navipack/navi-panel/Hardware/Smart Chassis control board schematic.pdf

D | D

# 激 光 雷 达

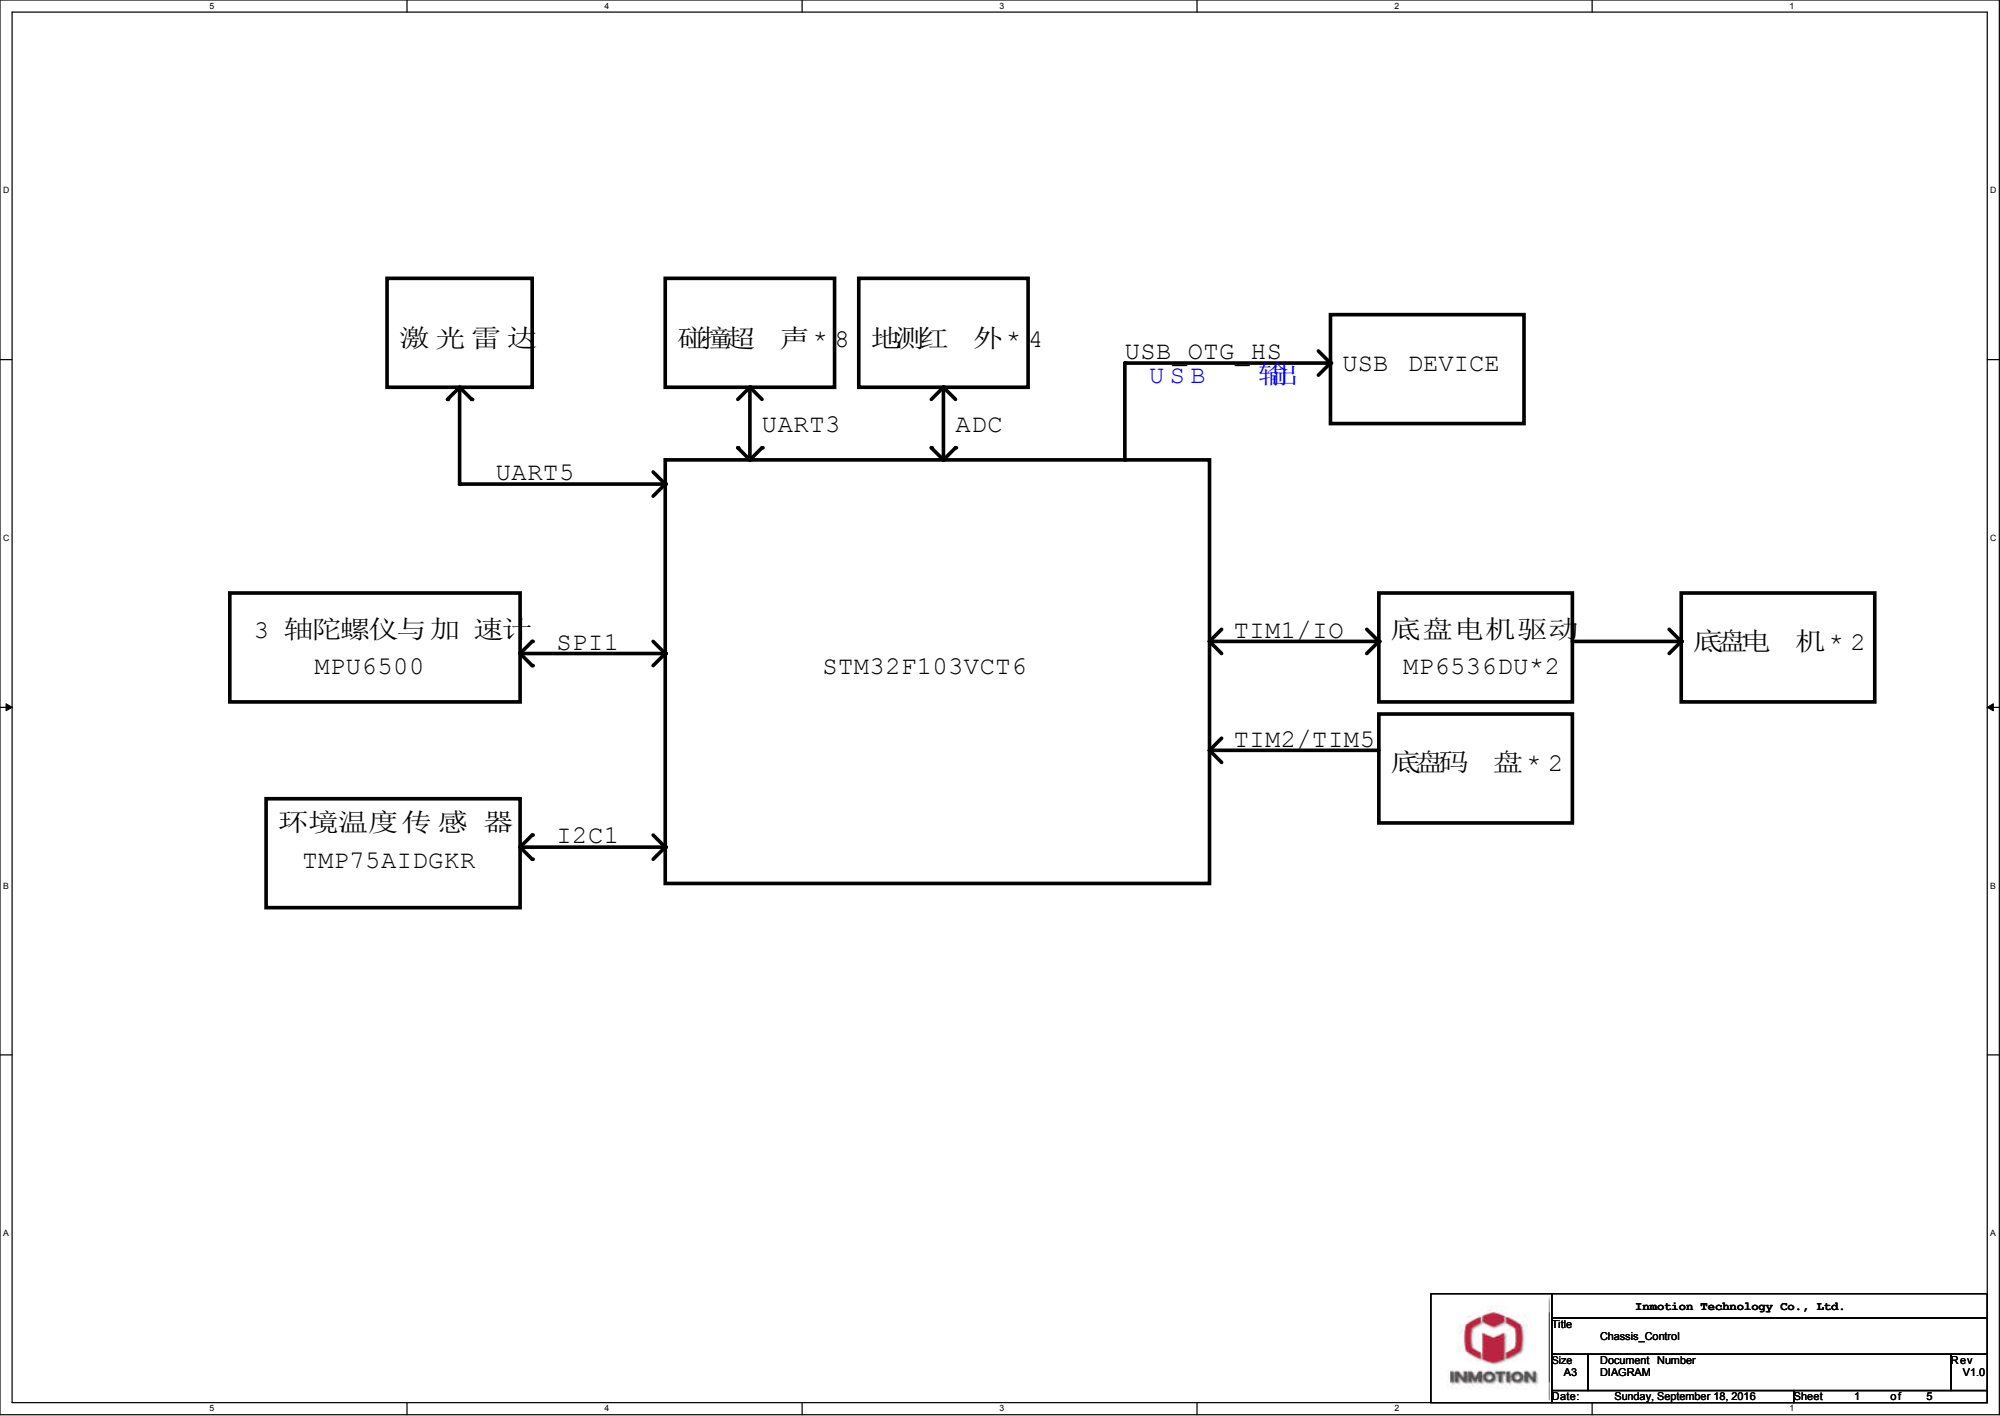
[picture p6: page 1]
STM32F103VCT6; UART5; MPU6500; SPI1 3 轴陀螺仪与加 速计; 碰撞超 声* 8; UART3; 地测红 外* 4; ADC; TMP75AIDGKR; 环境温度传 感 器; TIM1/IO; 底盘电机驱动; 底盘电 机* 2; 底盘码 盘* 2; TIM2/TIM5; USB_OTG_HS; USB DEVICE U S B; Title; Size; Document Number; Rev; Date:; Sheet; DIAGRAM; Chassis_Control; Sunday, September 18, 2016

Inmotion Technology Co., Ltd.

D | D

# CHARGE

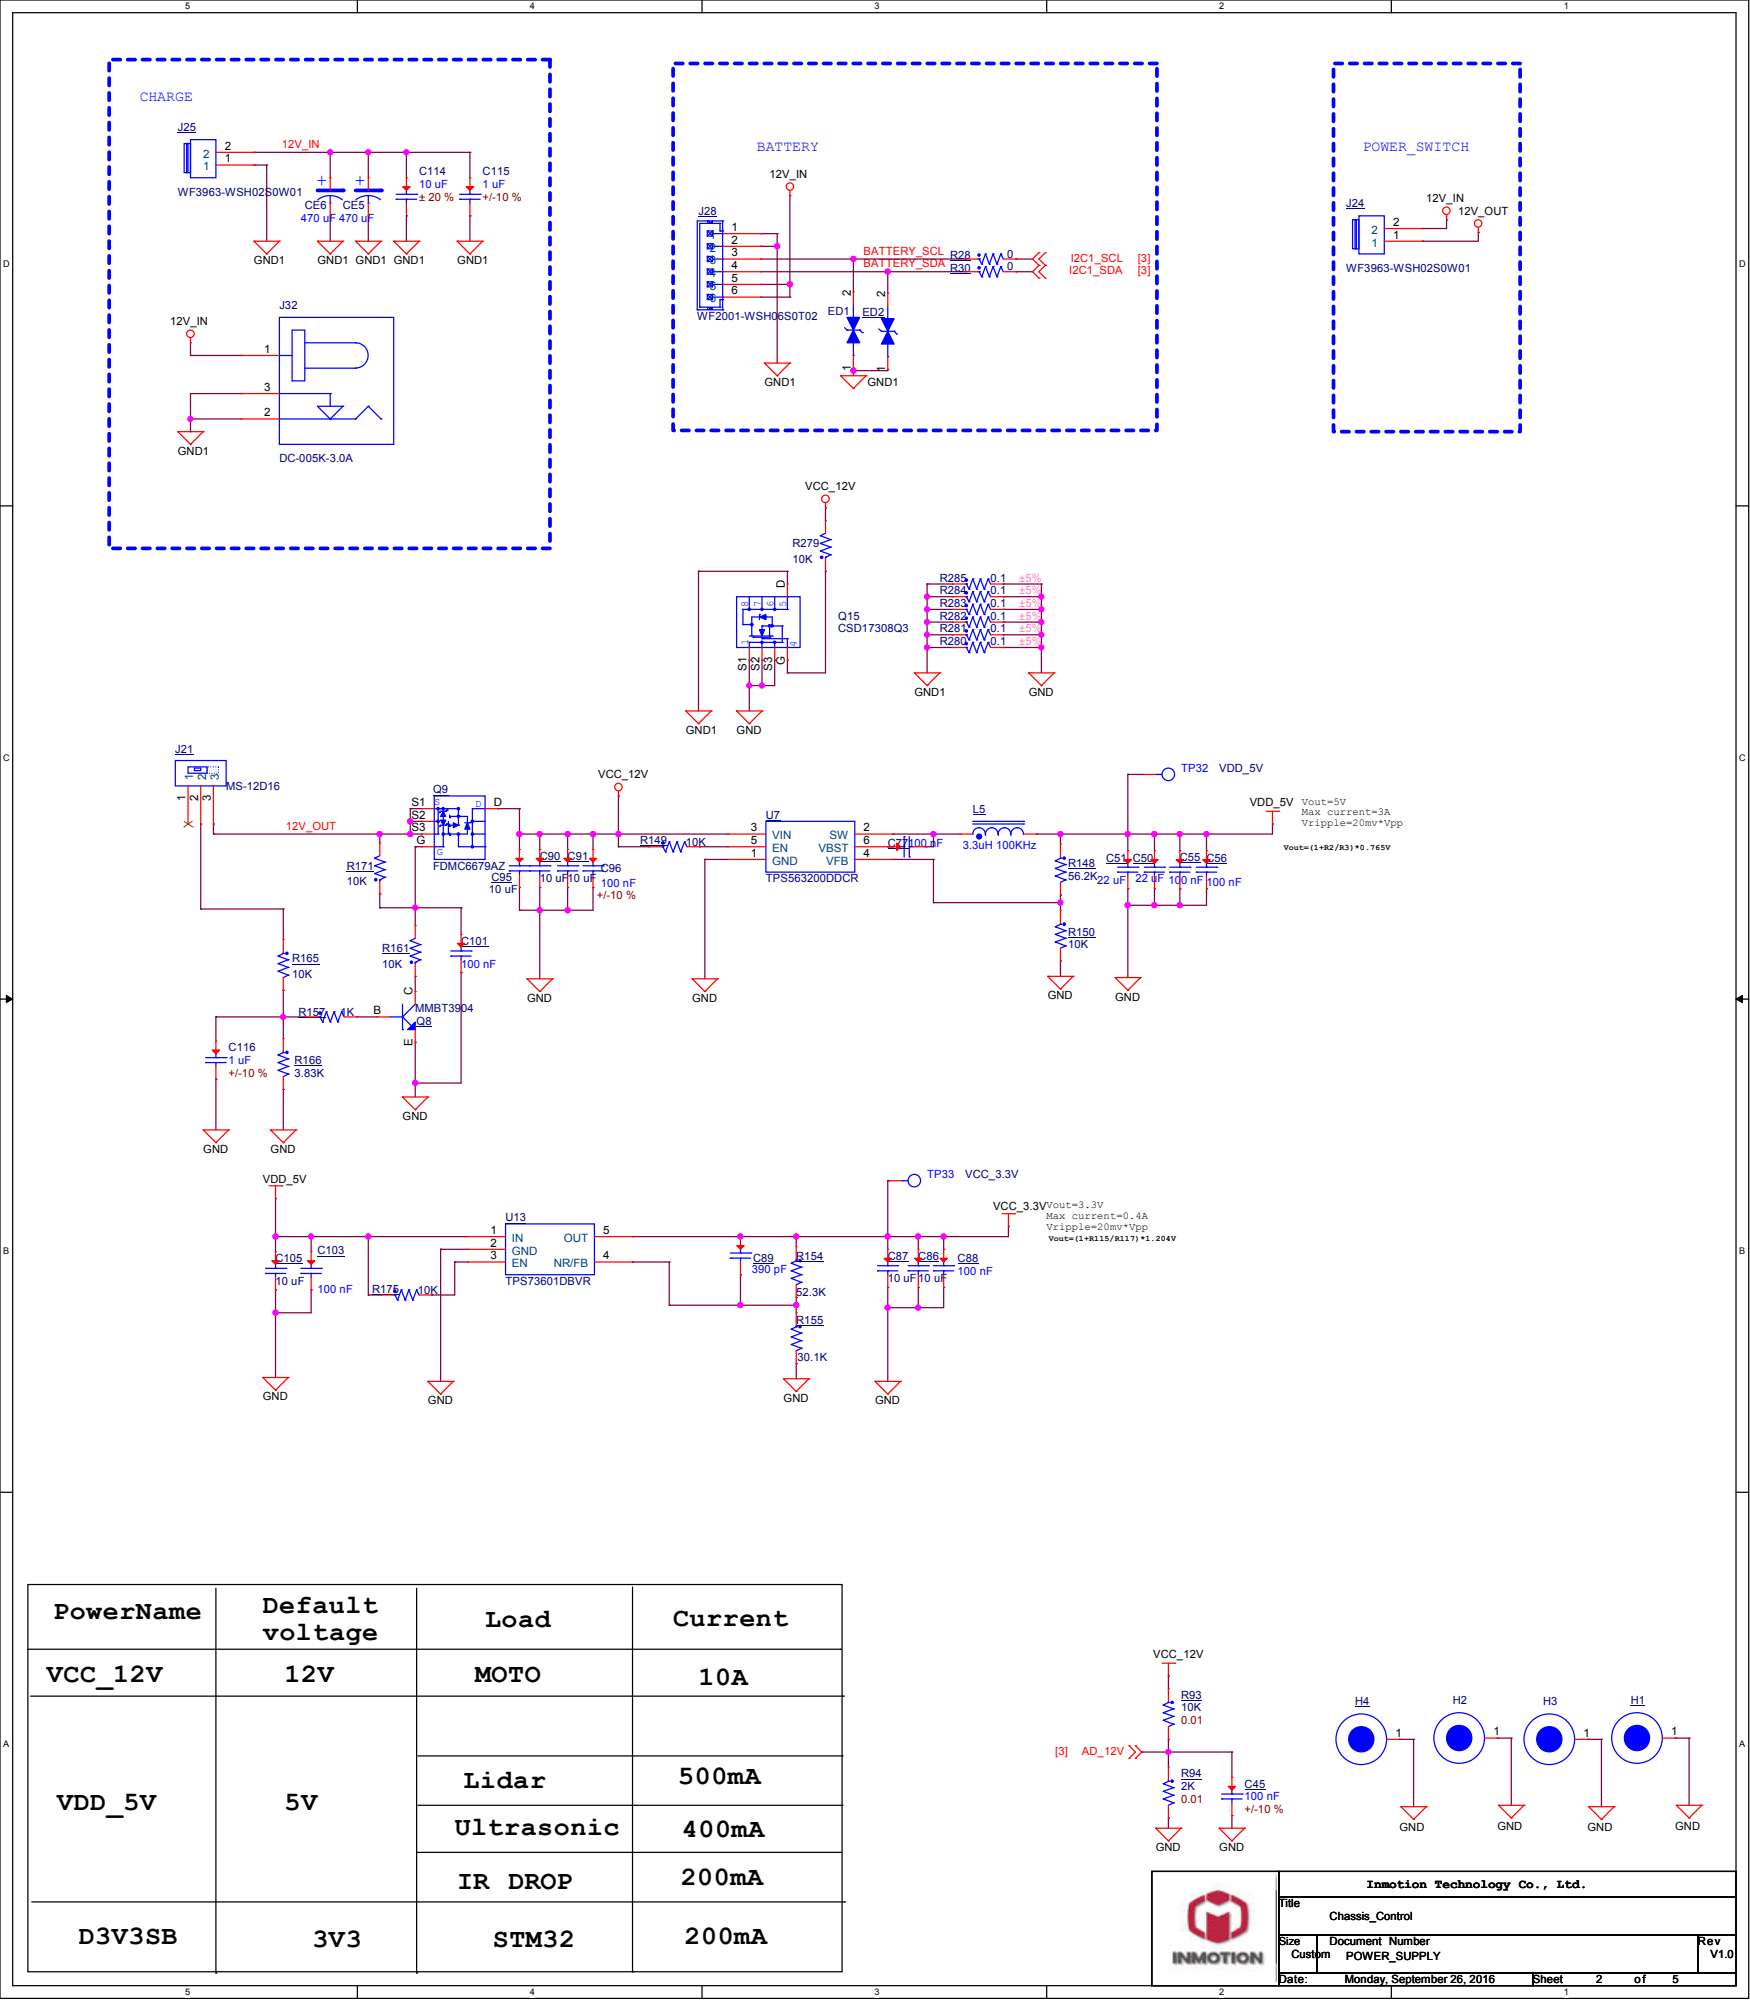
[picture p7: page 2]

# DEBUG

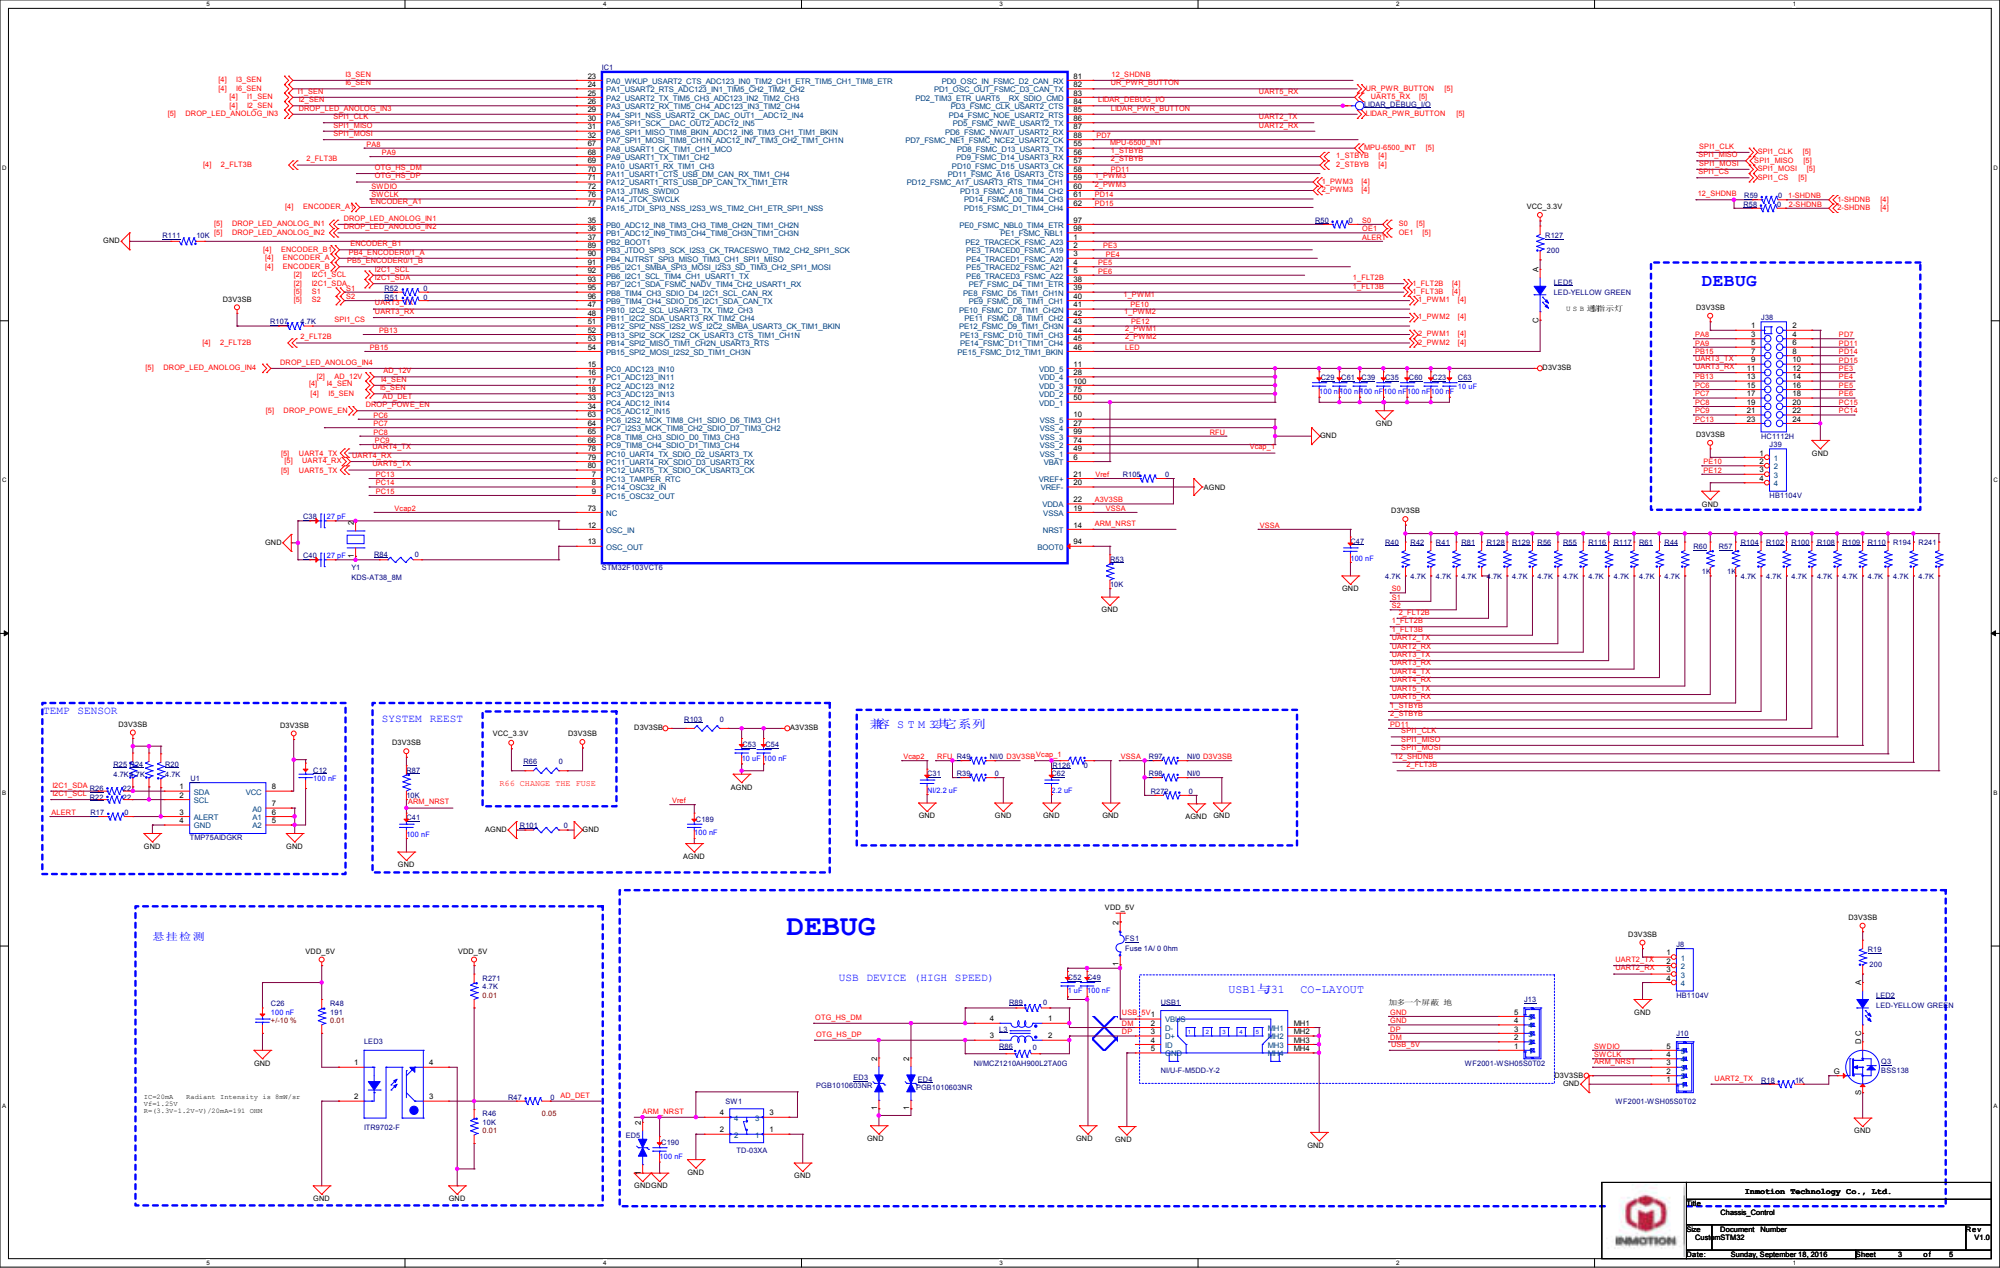
[picture p8: page 3]

USB DEVICE (HIGH SPEED)

MOTOR DRIVER | CURRENT SAMPLING 1-FAULTB

+

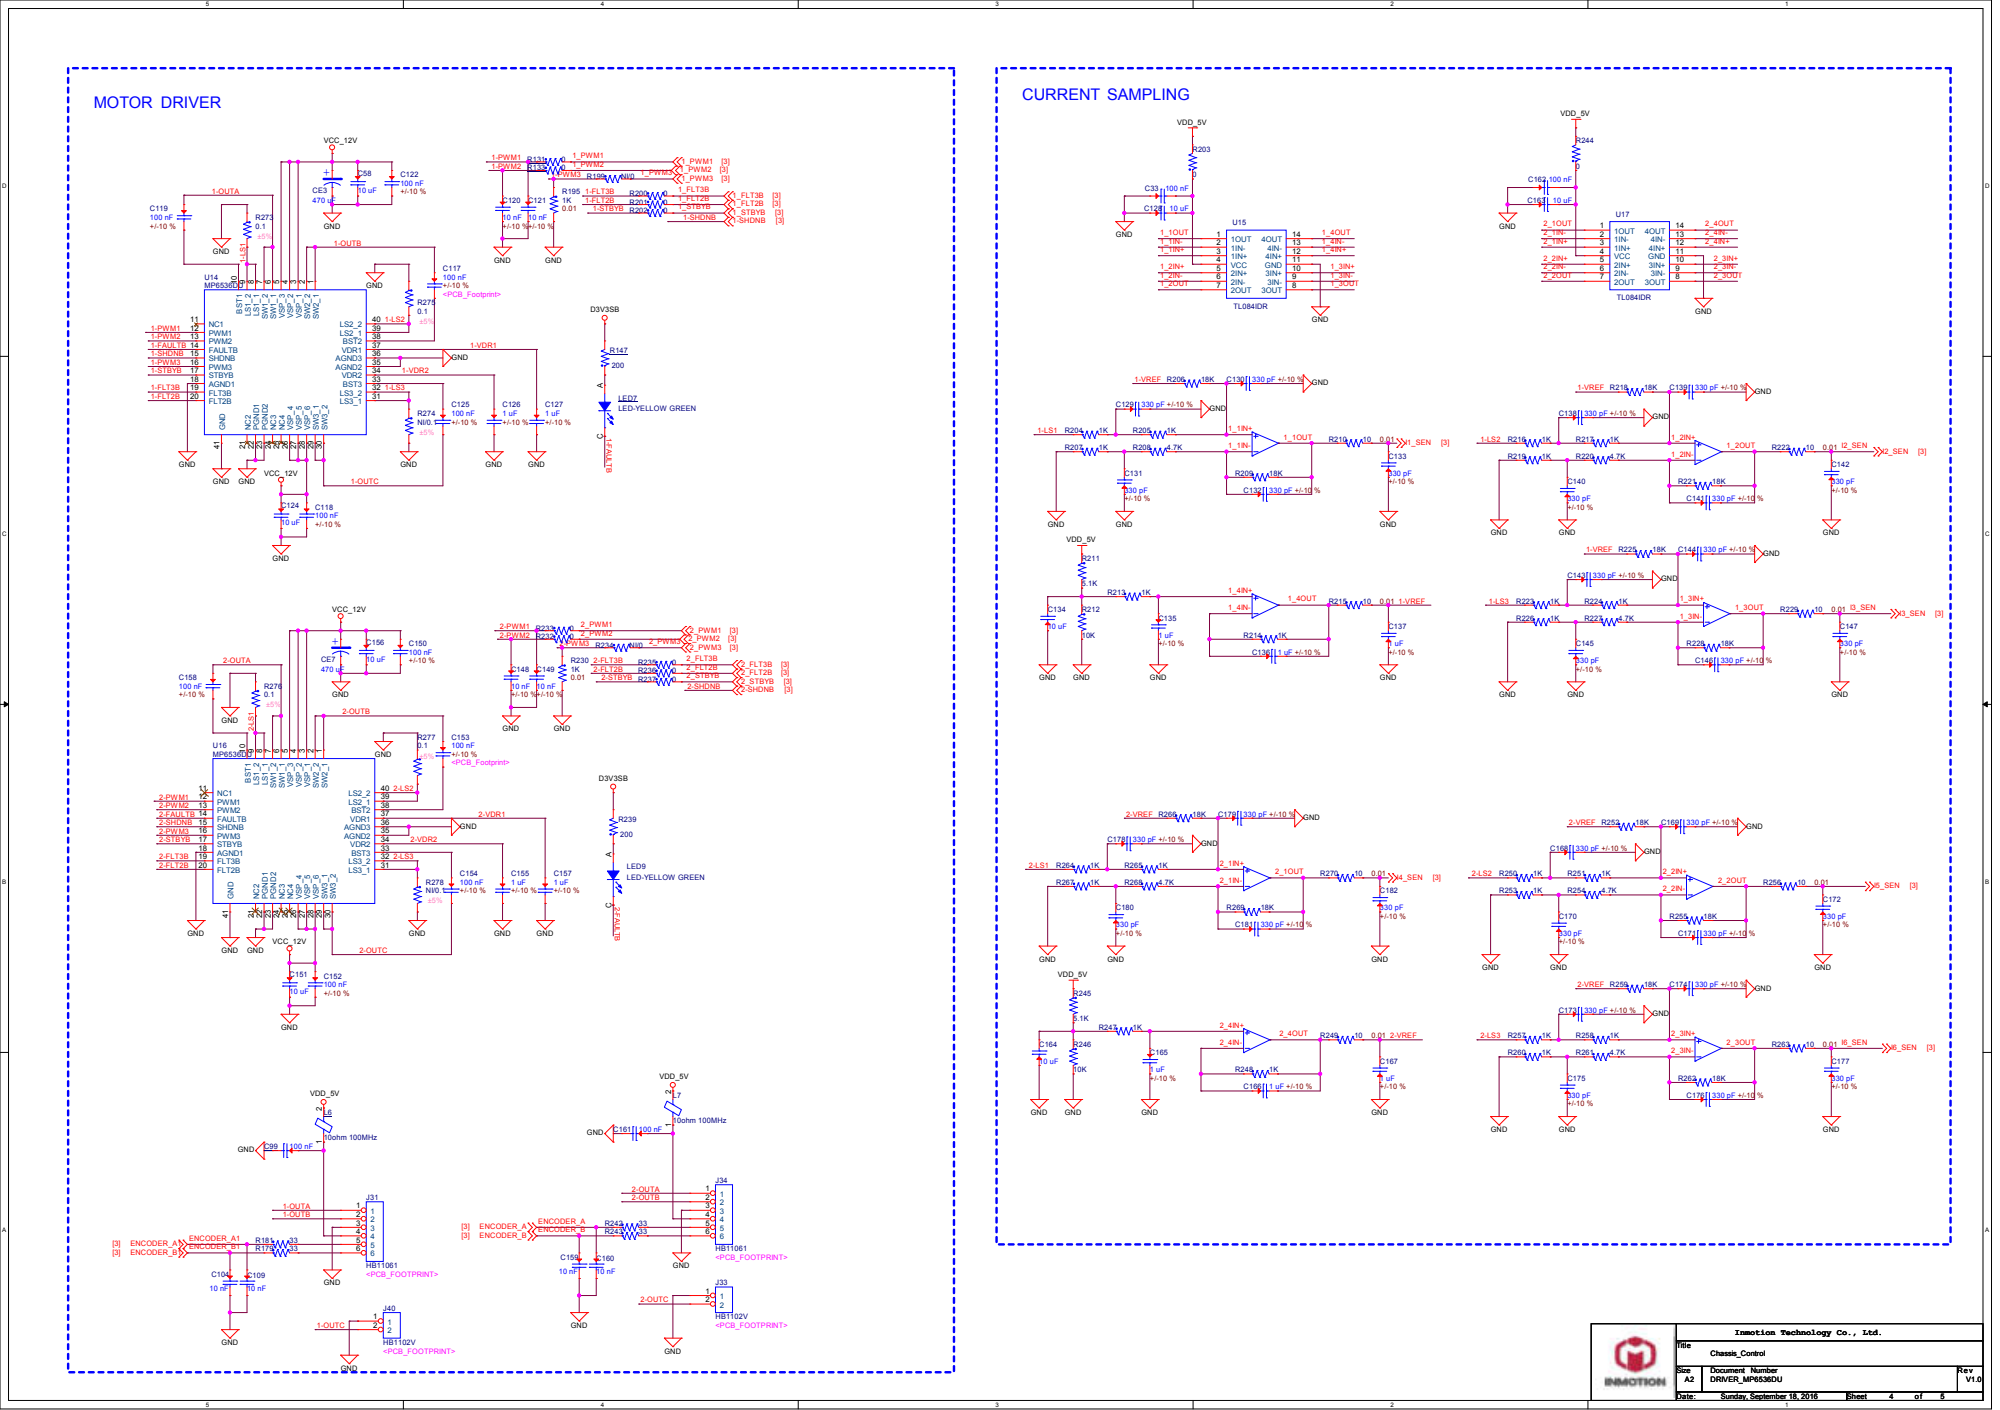
[picture p9: page 4]

## three-axis digital output gyroscope and Accelerometer

## Lidar_Power

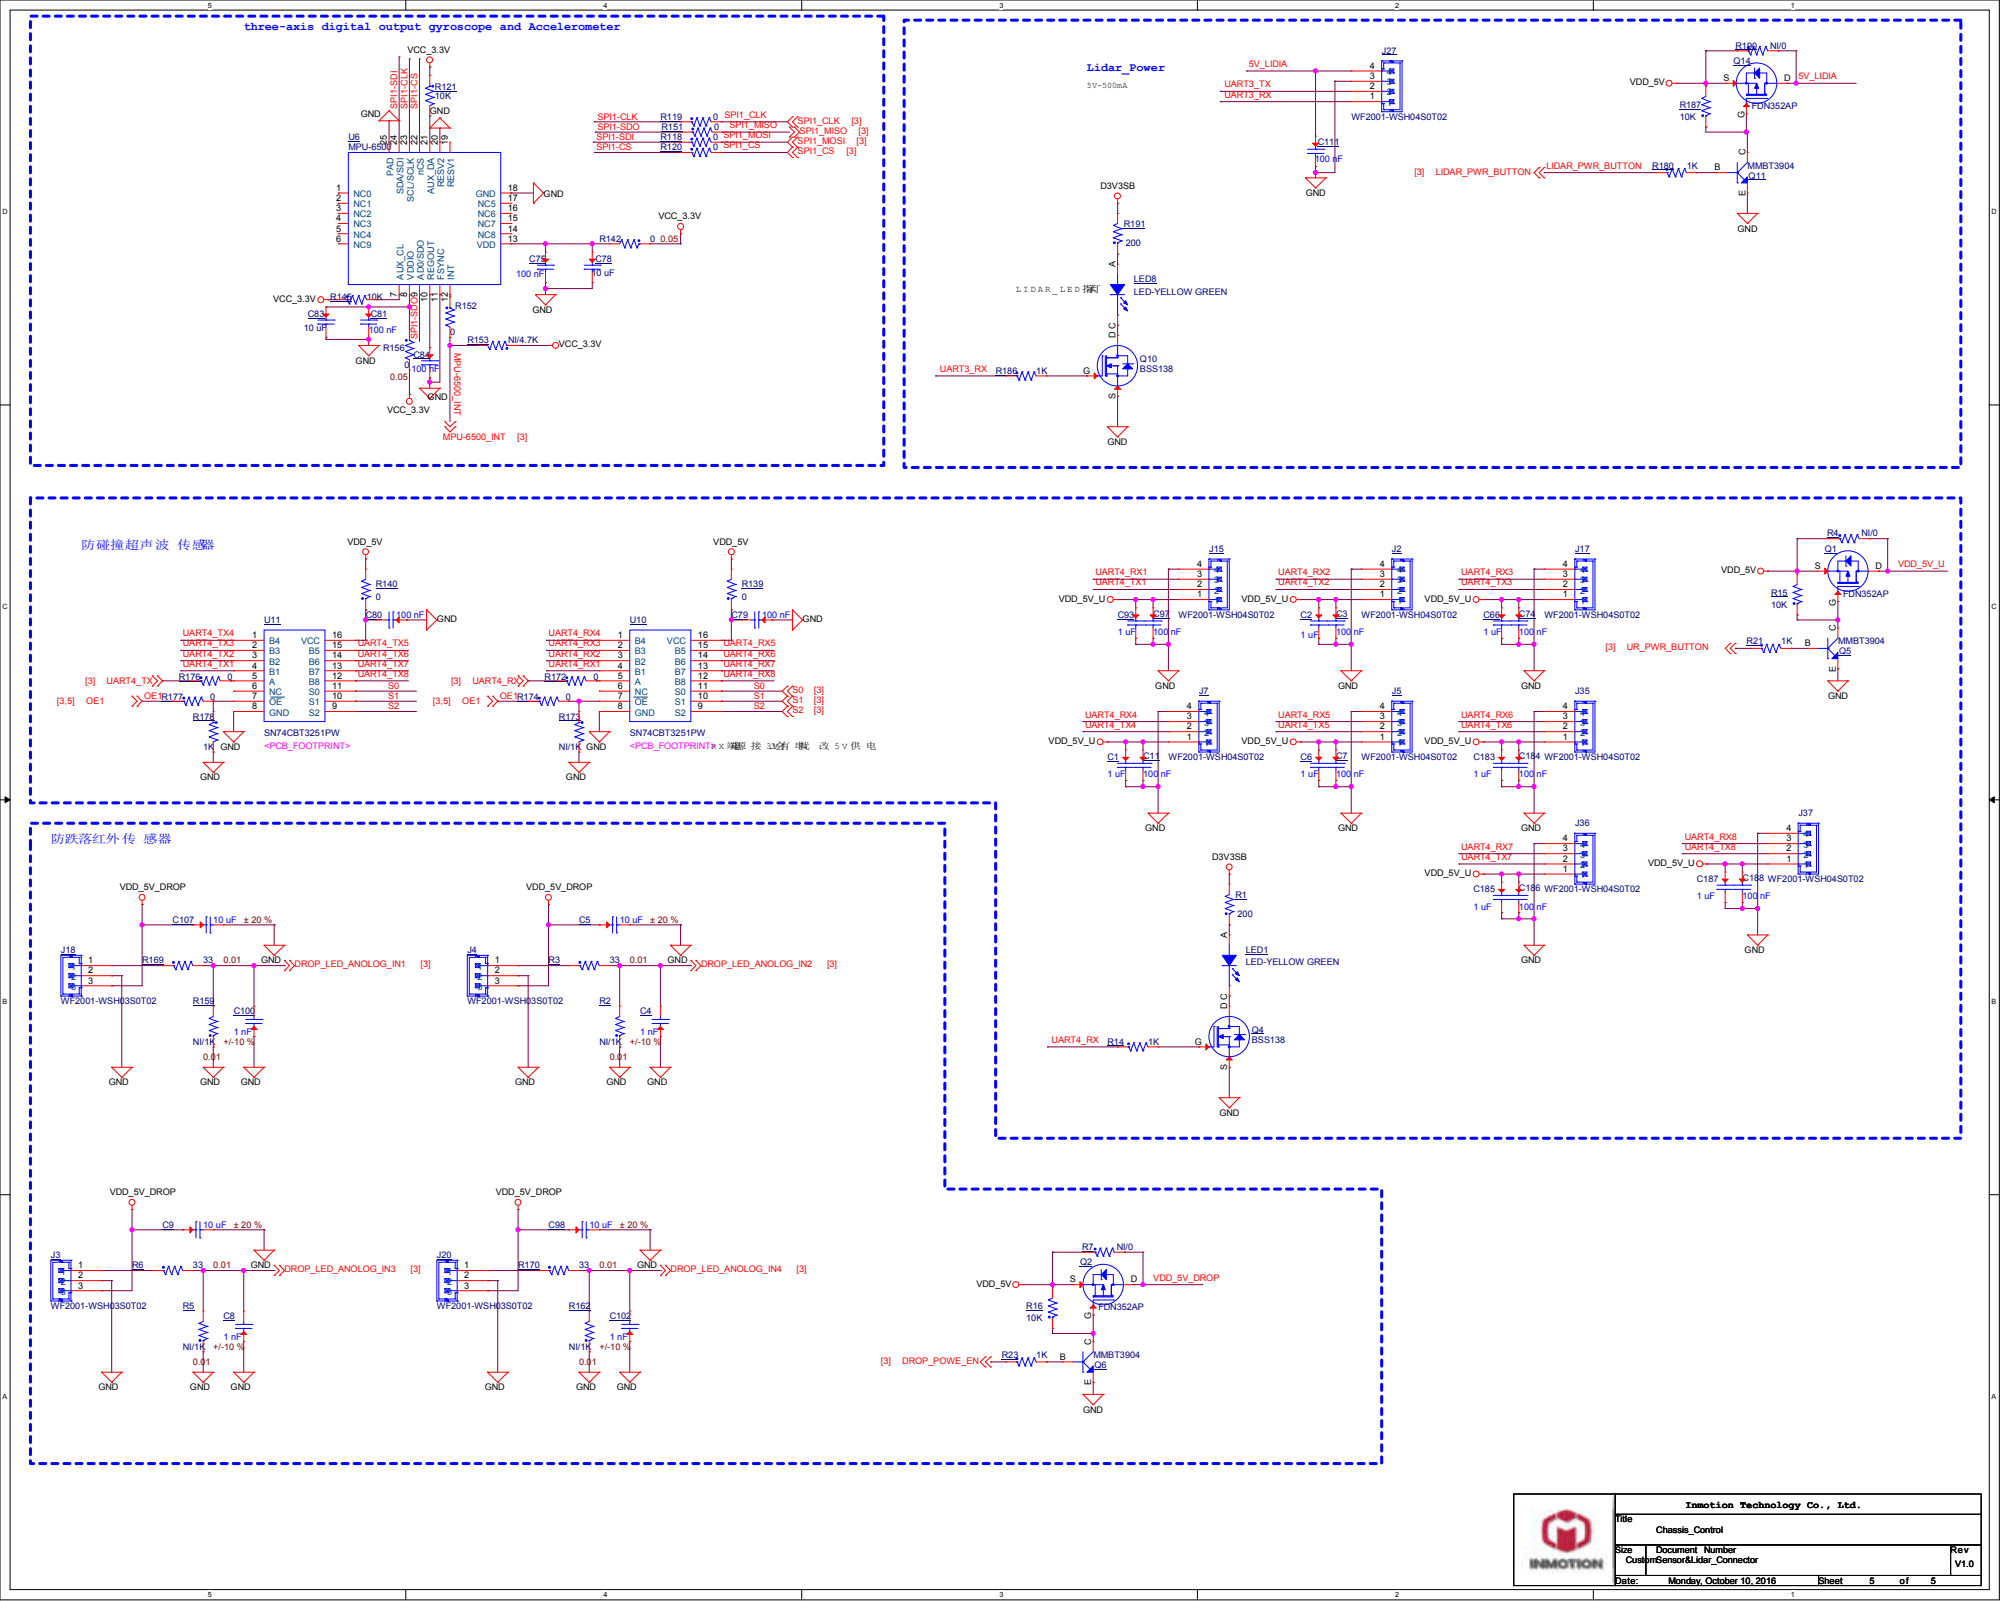
[picture p10: page 5]

RESV2 20 AUX_DA 21 AD0/SDO 9 FSYNC 11 VDDIO 8 REGOUT 10
