navipack/navi-panel/Hardware/Smart Chassis control board 装配图.pdf

## ART FILM - 08_SILKSCREEN_TOP

# US5R191 R42 R59 R58 R194

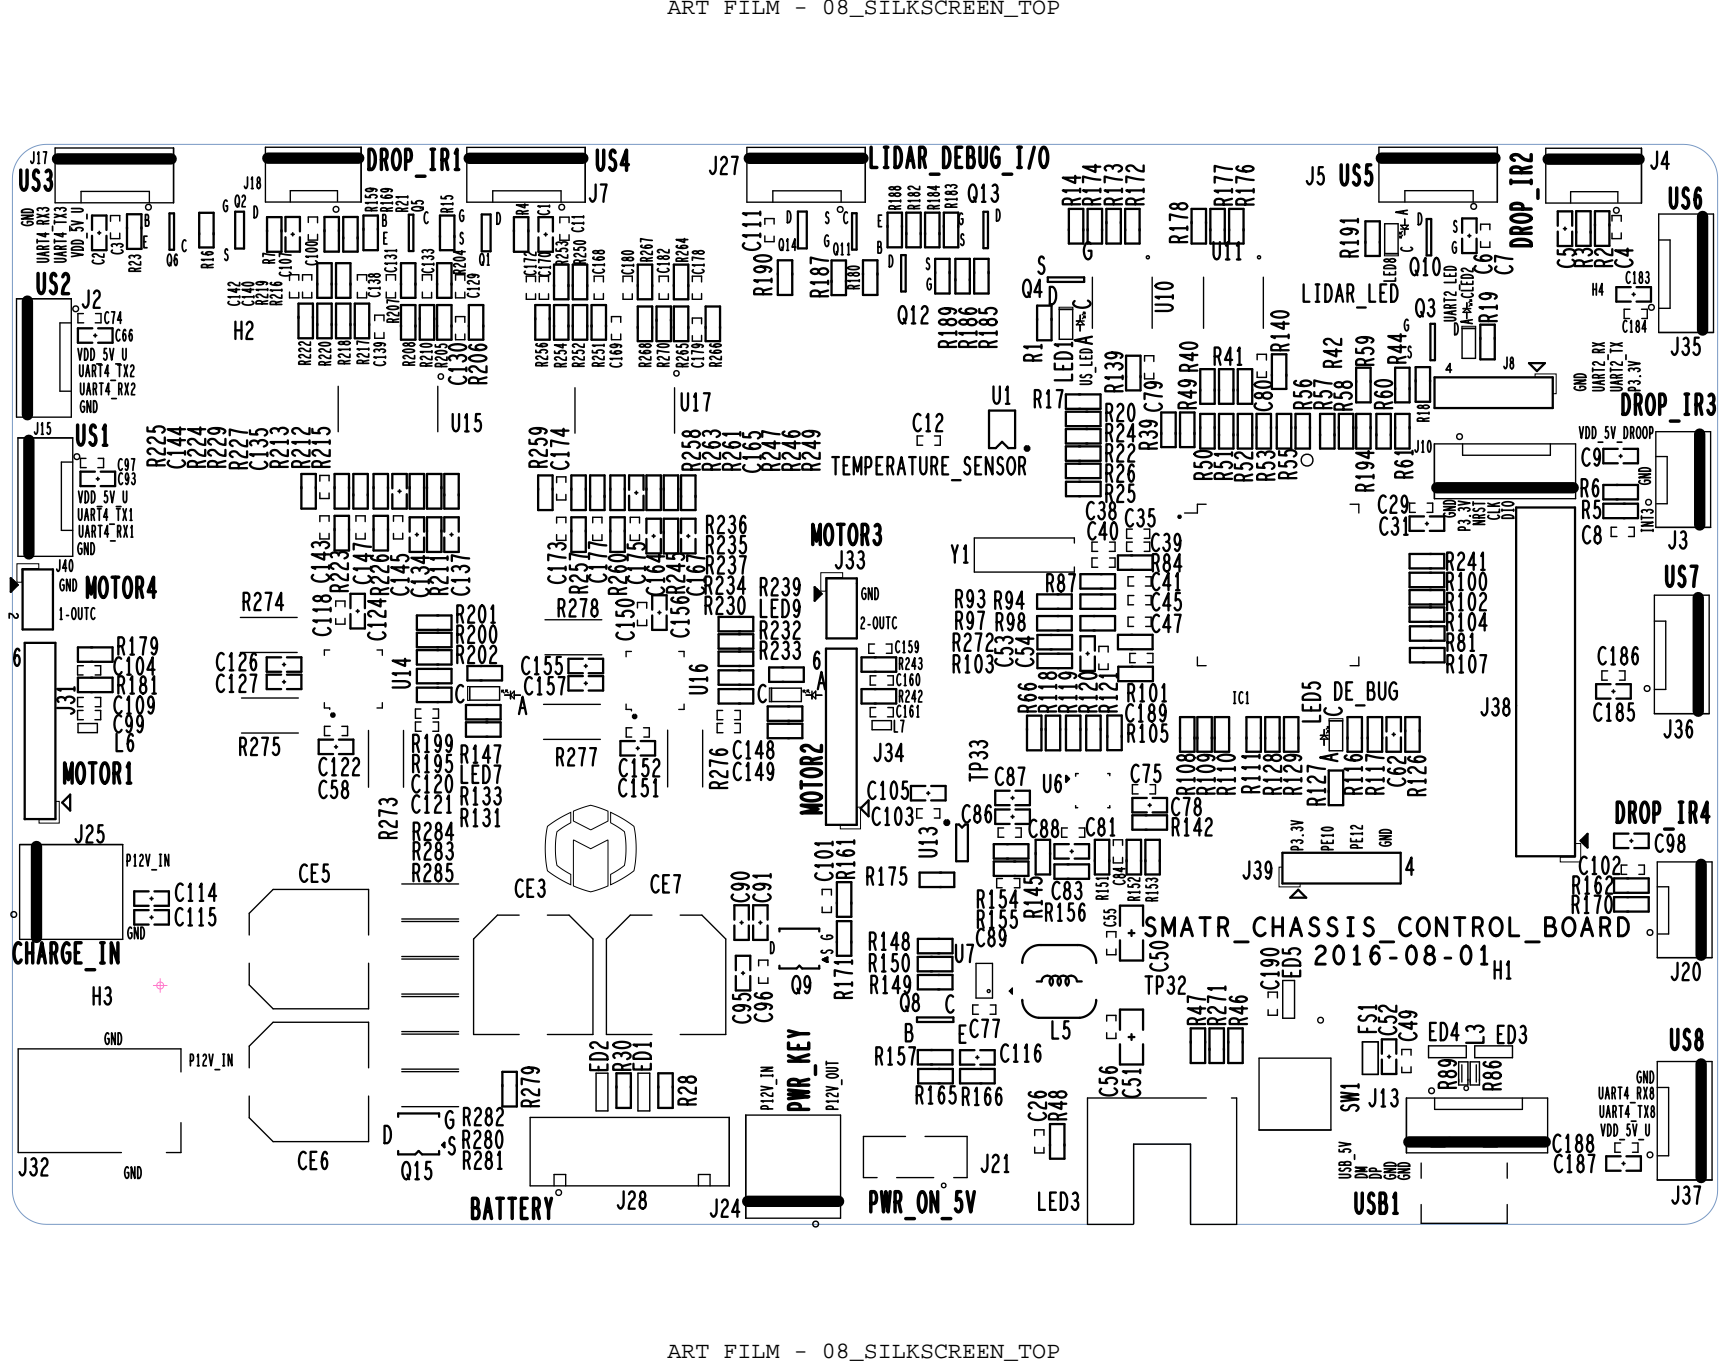
[picture p11: page 1]
