navipack/navi-panel/Software/HAL/Src/main.c

/**
  ******************************************************************************
  * File Name          : main.c
  * Description        : Main program body
  ******************************************************************************
  *
  * Copyright (c) 2017 STMicroelectronics International N.V. 
  * All rights reserved.
  *
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
  ******************************************************************************
  */
/* Includes ------------------------------------------------------------------*/
#include "main.h"
#include "stm32f1xx_hal.h"
#include "adc.h"
#include "dma.h"
#include "i2c.h"
#include "spi.h"
#include "tim.h"
#include "usart.h"
#include "usb_device.h"
#include "gpio.h"

/* USER CODE BEGIN Includes */
#include "tim_user.h"
#include "gpio_user.h"
#include "inv_mpu_driver.h"
#include "adc_user.h"
#include "comm_usart.h"
#include "Encoder.h"
#include "system_supervise.h"
#include "speed_loop.h"
#include "motion_control.h"
#include "sensor_update.h"
#include "Ultrasonic.h"
#include "comm.h"
#include "motor.h"
#include "global_defines.h"
#include "contact_detection.h"

/* USER CODE END Includes */


/* USER CODE BEGIN PV */

/* USER CODE END PV */

void SystemClock_Config(void);
void Error_Handler(void);

/* USER CODE BEGIN PFP */

/* USER CODE END PFP */

/* USER CODE BEGIN 0 */
/** Drivers init
*/
void DriverInit(void)
{
    // Chassis Encoder
    MX_TIM2_Init();
    MX_TIM3_Init();
    //MX_TIM5_Init();
    __HAL_TIM_ENABLE_IT(&htim2, TIM_IT_UPDATE);
    __HAL_TIM_ENABLE_IT(&htim3, TIM_IT_UPDATE);
    //__HAL_TIM_ENABLE_IT(&htim5, TIM_IT_UPDATE);
    EncInit(0);
    EncInit(1);
    //EncInit(2);
    HAL_TIM_Encoder_Start(&htim2, TIM_CHANNEL_ALL);
    HAL_TIM_Encoder_Start(&htim3, TIM_CHANNEL_ALL);
    //HAL_TIM_Encoder_Start(&htim5, TIM_CHANNEL_ALL);

    // Basic Timer
    MX_TIM7_Init();
    __HAL_TIM_ENABLE_IT(&htim7, TIM_IT_UPDATE);
    HAL_TIM_Base_Start(&htim7);
    
    // Chassis PWM
    MX_TIM1_Init();
    HAL_TIM_PWM_Start(&htim1, TIM_CHANNEL_1);
    HAL_TIM_PWM_Start(&htim1, TIM_CHANNEL_2);
    HAL_TIM_PWM_Start(&htim1, TIM_CHANNEL_3);
    HAL_TIM_PWM_Start(&htim1, TIM_CHANNEL_4);

    // MPU
    MX_SPI1_Init();
    InvMPU_Driver_Init();
    
    // ADC
    DropPower(true);
    MX_ADC1_Init();
    MX_ADC2_Init();
    ADC_Init(&hadc1);
    HAL_ADC_Start(&hadc2);
//    __HAL_ADC_ENABLE_IT(&hadc1, ADC_IT_JEOC);
//    __HAL_ADC_ENABLE_IT(&hadc2, ADC_IT_JEOC);
//    HAL_ADCEx_InjectedStart(&hadc1);
//    HAL_ADCEx_InjectedStart(&hadc2);
    
//    //MX_ADC3_Init();
//    //HAL_ADC_Start(&hadc3);
//    ShuntDuoCurrentReadingCalibration_DualMode();
//    //HeadCurrentCalibration();

    // Lidar Communication
    Comm_Init();
    if(GlobalParams.commMode == COMM_UART)
    {
        MX_USART3_UART_Init();
        CommUsart_Init(GetCommUartHandle(), &huart3);
    }
    else
    {
        // USB
        MX_USB_DEVICE_Init();
    }

    // I2C Battery and Temperature
    MX_I2C1_Init();
    #if 1 // SMBus Init
    __HAL_I2C_DISABLE(&hi2c1);
    SET_BIT( hi2c1.Instance->CR1, I2C_CR1_ENARP);
    SET_BIT( hi2c1.Instance->CR1, I2C_CR1_SMBTYPE);
    SET_BIT( hi2c1.Instance->CR1, I2C_CR1_SMBUS);
    __HAL_I2C_ENABLE(&hi2c1);
    #endif
}
/* USER CODE END 0 */

int main(void)
{

  /* MCU Configuration----------------------------------------------------------*/

  /* Reset of all peripherals, Initializes the Flash interface and the Systick. */
  HAL_Init();

  /* Configure the system clock */
  SystemClock_Config();

  /* Initialize all configured peripherals */
  MX_GPIO_Init();
  MX_DMA_Init();

  /* USER CODE BEGIN 2 */
    DriverInit();
    SystemSuperviseInit();
    Ultrasonic_Init();
    Motor_Init();
    
    HAL_GPIO_WritePin(STBYB_1_GPIO_Port, STBYB_1_Pin, GPIO_PIN_SET);
    HAL_GPIO_WritePin(STBYB_2_GPIO_Port, STBYB_2_Pin, GPIO_PIN_SET);
  /* USER CODE END 2 */

  /* Infinite loop */
  /* USER CODE BEGIN WHILE */
    while (1)
    {
        RunFlagHandler();
        Comm_RxTask();
        MotionCtrlTask();
        SensorUpdateTask();
        SystemSuperviseTask();
        UltrsonicTrigTask();
        Comm_BoostTask();
        Comm_TxTask();
        //Contact_detection();
  /* USER CODE END WHILE */

  /* USER CODE BEGIN 3 */
    }
  /* USER CODE END 3 */

}

/** System Clock Configuration
*/
void SystemClock_Config(void)
{

  RCC_OscInitTypeDef RCC_OscInitStruct;
  RCC_ClkInitTypeDef RCC_ClkInitStruct;
  RCC_PeriphCLKInitTypeDef PeriphClkInit;

    /**Initializes the CPU, AHB and APB busses clocks 
    */
  RCC_OscInitStruct.OscillatorType = RCC_OSCILLATORTYPE_HSE;
  RCC_OscInitStruct.HSEState = RCC_HSE_ON;
  RCC_OscInitStruct.HSEPredivValue = RCC_HSE_PREDIV_DIV1;
  RCC_OscInitStruct.HSIState = RCC_HSI_ON;
  RCC_OscInitStruct.PLL.PLLState = RCC_PLL_ON;
  RCC_OscInitStruct.PLL.PLLSource = RCC_PLLSOURCE_HSE;
  RCC_OscInitStruct.PLL.PLLMUL = RCC_PLL_MUL9;
  if (HAL_RCC_OscConfig(&RCC_OscInitStruct) != HAL_OK)
  {
    Error_Handler();
  }

    /**Initializes the CPU, AHB and APB busses clocks 
    */
  RCC_ClkInitStruct.ClockType = RCC_CLOCKTYPE_HCLK|RCC_CLOCKTYPE_SYSCLK
                              |RCC_CLOCKTYPE_PCLK1|RCC_CLOCKTYPE_PCLK2;
  RCC_ClkInitStruct.SYSCLKSource = RCC_SYSCLKSOURCE_PLLCLK;
  RCC_ClkInitStruct.AHBCLKDivider = RCC_SYSCLK_DIV1;
  RCC_ClkInitStruct.APB1CLKDivider = RCC_HCLK_DIV2;
  RCC_ClkInitStruct.APB2CLKDivider = RCC_HCLK_DIV1;

  if (HAL_RCC_ClockConfig(&RCC_ClkInitStruct, FLASH_LATENCY_2) != HAL_OK)
  {
    Error_Handler();
  }

  PeriphClkInit.PeriphClockSelection = RCC_PERIPHCLK_ADC|RCC_PERIPHCLK_USB;
  PeriphClkInit.AdcClockSelection = RCC_ADCPCLK2_DIV6;
  PeriphClkInit.UsbClockSelection = RCC_USBCLKSOURCE_PLL_DIV1_5;
  if (HAL_RCCEx_PeriphCLKConfig(&PeriphClkInit) != HAL_OK)
  {
    Error_Handler();
  }

    /**Configure the Systick interrupt time 
    */
  HAL_SYSTICK_Config(HAL_RCC_GetHCLKFreq()/1000);

    /**Configure the Systick 
    */
  HAL_SYSTICK_CLKSourceConfig(SYSTICK_CLKSOURCE_HCLK);

  /* SysTick_IRQn interrupt configuration */
  HAL_NVIC_SetPriority(SysTick_IRQn, 0, 0);
}

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
