navipack/navi-panel/Software/HAL/navi-panel.ioc

Mcu.UserName=STM32F103VCTx
PA0-WKUP.Signal=ADCx_IN0
PA1.Signal=ADCx_IN1
PA11.Signal=USB_DM
PA12.Signal=USB_DP
PA13.Signal=SYS_JTMS-SWDIO
PA14.Signal=SYS_JTCK-SWCLK
PA15.GPIO_Label=MOTOR1_ENCODER_A
PA15.Signal=S_TIM2_CH1_ETR
PA2.GPIO_Label=I1_SEN
PA2.Signal=ADCx_IN2
PA3.GPIO_Label=I2_SEN
PA3.Signal=GPIO_Analog
PA4.GPIO_Label=DROP_IN3
PA4.Signal=ADCx_IN4
PA5.Signal=SPI1_SCK
PA6.Signal=SPI1_MISO
PA7.Signal=SPI1_MOSI
PB0.GPIO_Label=DROP_IN1
PB0.Signal=ADCx_IN8
PB1.GPIO_Label=DROP_IN2
PB1.Signal=ADCx_IN9
PB10.Signal=USART3_TX
PB11.Signal=USART3_RX
PB12.GPIO_Label=SPI_CS
PB12.Signal=GPIO_Output
PB14.GPIO_Label=FALUT2
PB14.Signal=GPIO_Input
PB3.GPIO_Label=MOTOR1_ENCODER_B
PB3.Signal=S_TIM2_CH2
PB4.GPIO_Label=MOTOR2_ENCODER_A
PB4.Signal=S_TIM3_CH1
PB5.GPIO_Label=MOTOR2_ENCODER_B
PB5.Signal=S_TIM3_CH2
PB6.Signal=I2C1_SCL
PB7.Signal=I2C1_SDA
PB8.GPIO_Label=S1
PB8.Signal=GPIO_Output
PB9.GPIO_Label=S2
PB9.Signal=GPIO_Output
PC0.GPIO_Label=DROP_IN4
PC0.Signal=ADCx_IN10
PC1.GPIO_Label=AD_12V
PC1.Signal=ADCx_IN11
PC10.GPIO_Label=US_TRIGGER
PC10.Signal=GPIO_Output
PC11.GPIO_Label=US_ECHO
PC11.Signal=GPXTI11
PC13-TAMPER-RTC.GPIO_Label=COMM_MODE
PC13-TAMPER-RTC.Signal=GPIO_Input
PC2.GPIO_Label=I4_SEN
PC2.Signal=ADCx_IN12
PC3.GPIO_Label=I5_SEN
PC3.Signal=GPIO_Analog
PC4.GPIO_Label=DROP_IN_T
PC4.Signal=ADCx_IN14
PC5.GPIO_Label=DROP_POWE_EN
PC5.Signal=GPIO_Output
PD0.GPIO_Label=SHDNB_12
PD0.Signal=GPIO_Output
PD1.GPIO_Label=UR_PWR_BUTTON
PD1.Signal=GPIO_Output
PD10.GPIO_Label=STBYB_2
PD10.Signal=GPIO_Output
PD4.GPIO_Label=RADAR_PWR_BUTTON
PD4.Signal=GPIO_Output
PD5.Signal=GPIO_Output
PD8.GPIO_Label=MPU-6500_INT
PD8.Signal=GPIO_Input
PD9.GPIO_Label=STBYB_1
PD9.Signal=GPIO_Output
PE0.GPIO_Label=S0
PE0.Signal=GPIO_Output
PE1.GPIO_Label=OE1
PE1.Signal=GPIO_Output
PE11.GPIO_Label=MOTOR1_PWM2
PE11.Signal=S_TIM1_CH2
PE13.GPIO_Label=MOTOR2_PWM1
PE13.Signal=S_TIM1_CH3
PE14.GPIO_Label=MOTOR2_PWM2
PE14.Signal=S_TIM1_CH4
PE15.GPIO_Label=LED
PE15.Signal=GPIO_Output
PE2.GPIO_Label=ALERT
PE2.Signal=GPIO_Input
PE7.GPIO_Label=FALUT1
PE7.Signal=GPIO_Input
PE9.GPIO_Label=MOTOR1_PWM1
PE9.Signal=S_TIM1_CH1
