navipack/navi-panel/Software/Source/App/motion_control.c

/**
******************************************************************************
* @file    motion_control.c
* @author  Inmotion NaviPanel team
* @date    2016/09/14
* @brief   运动控制模块，包含了一些加减速和初始化之类的算法
* @attention Copyright (C) 2016 Inmotion Corporation
******************************************************************************
*/

#include "motion_control.h"
#include "global_defines.h"
#include "system_supervise.h"
#include "math.h"
#include "Queue.h"
#include "math_lib.h"
#include "gpio_user.h"
#include "sensor_update.h"
#include "comm.h"
#include "infrared_drop.h"
#include "tim_user.h"
#include "speed_loop.h"

#define FREQ(cnt,hz)  (++(cnt) >= MOTION_PREQ/(hz))

/////////////////// Local Variable ////////////////////////
static CSpeedVW TargetSpeed = {0, 0};
static u8 VW_Update = 0;

static bool CarMotionEnable = true;


/**
* @brief  一阶滞后融合滤波
* @param  target_value   : 目标值
* @param  sample_value   : 采样值
* @param  factor         : 滞后程度
* @retval 结果
*/
s32 FirstFilterS32(s32 target_value, s32 sample_value, s16 factor)
{    
    return ((s64)target_value * factor + (s64)sample_value * (1000 - factor))/1000;    
}

/**
* @brief  底盘位姿更新
* @param  present_location        : 融合位姿数据
* @param  no_fusion_distance      : 不融合位姿数据
* @param  present_speed           : 速度
* @param  period                  : 周期时间，单位微秒
* @retval None
*/
#define W_NOISE_TH  (DEGREE(1)/4)
void CarLocationUpdate(CDistanceValue* distance, const CSpeedVW *present_speed, s32 period )
{
    s32 delta_theta;
    s32 delta_distance = 0;
    static s32 delta_theta_remainder;
    static s32 delta_distance_remainder;
    
    //位移
    delta_distance = present_speed->sV * period + delta_distance_remainder;
    delta_distance_remainder = delta_distance % 1000000;
    delta_distance /= 1000000;
    
    //角度变化，左转弯为角速度正方向
    if(abs(present_speed->sW) < W_NOISE_TH)
    {
        delta_theta = 0;
    }
    else
    {
        delta_theta = present_speed->sW * period + delta_theta_remainder;
        delta_theta_remainder = delta_theta % 1000000;
        delta_theta /= 1000000;
    }
    
    distance->theta += delta_theta;

    distance->theta %= DEGREE(360);
    if(distance->theta < 0)
	{
		distance->theta += DEGREE(360);
	}
    
    distance->distance += delta_distance;
}

/**
* @brief  设置VW模式的速度值
* @param  v: 线速度
* @param  w: 角速度
* @param  t: 运行时间
* @retval None
*/
void SetVWValue(s32 v, s32 w, u16 t)
{
//    if(v == 0 && w != 0 && abs(w) < 150)
//    {
//        w = ((w >> 8) | 0x01) * 150;
//    }
    
    TargetSpeed.sV = v;
    TargetSpeed.sW = w;
    //TargetSpeed.time = t * (MOTION_PREQ/1000);
    VW_Update = 1;
}

//void SetCarMotionEnable(bool b)
//{
//    CarMotionEnable = b;
//}


/**
* @brief  传感器触发的停止动作处理
* @param  target: 输出速度值
* @param  freq  : 调用频率
* @retval 是否处于危险保护状态
*/
bool DropAndCollisionSensorHandler(CSpeedVW *target, u16 freq)
{
    static bool drop_stop = false, collision_stop = false, is_protect = false;
    static u8 last_collision = 0;
    static bool last_collision_stop=0;
    static u16 time_cnt = 0, dealy_cnt = 0;
    
    u8 drop, collision;
    
    // 跌落传感器数据
    drop = InfraredDrop_GetData();
    drop_stop = (drop != 0);
    NavipackComm.status.dropSensor = drop;
    
   // 碰撞传感器数据 
    collision = 0;
    collision_stop = (collision != 0);
    NavipackComm.status.collisionSensor = collision;
    
#ifdef _DEBUG
    if(UserReg.debug_flag & 0x02)
    {
        return false;
    }
#endif

    if(drop_stop || collision_stop)
    {
        if(target->sV > 0 || target->sW != 0 )
        {
            is_protect = true;
            dealy_cnt = 0;     
        }
        
        if(is_protect)
        {
            // 保护模式的超时机制，防止一直保护
            if(time_cnt > 3*freq) // 3s
            {
                // Sensor error
                target->sV = 0;
                target->sW = 0;
            }
            else
            {
                time_cnt++;
                target->sV = -150;
                target->sW = 0;
            }
        }
    }
    else if(is_protect)
    {
        if(++dealy_cnt > abs(20*freq/target->sV)) // 20mm
        {
            is_protect = false;
            target->sV = 0;
            target->sW = 0;
            time_cnt = 0;
        }
    }

    return is_protect;
}

/**
* @brief  错误检查
* @retval 错误状态
*/
u32 MotionCheckErr(void)
{
#ifdef _DEBUG
    if(UserReg.debug_flag & 0x01)
    {
        return 0;
    }
    else
#endif
    {
        return CHECK_ERR(DRV_ERR_COMM_TIMEOUT | DRV_ERR_TILT);
    }
}

/**
* @brief  判断主动轮是否在转动
* @param  None
* @retval 是否转动
*/
bool IsWheelRest()
{
    if(MotorParams[0].present_speed == 0 && MotorParams[1].present_speed == 0) //编码器输出判断
    {
        return true;
    }
    return false;
}

/**
* @brief  底盘运动控制
* @param  None
* @retval None
*/
void ChassisMovingController()
{
    static u8 sample_idx = 0;
    static u16 stop_cnt;
    static bool is_protect = false;
    static CDistanceValue present_posture = {0,0};
    static CSpeedVW present_vw = {0,0};
    static CSpeedVW target_vw = {0,0};
    static NaviPack_StatusType* status = &NavipackComm.status;
    
    SpeedSampling(sample_idx);
    sample_idx ^= 0x01;
    
    present_vw = GlobalParams.presentVW;
    
    // 车当前位姿更新
    CarLocationUpdate(&present_posture, &present_vw, 1000000/MOTION_PREQ);
    
    // 通讯反馈
    if(Navipack_LockReg(REG_ID_STATUS))
    {
        status->angularPos = DEGREE_TO_RADIAN(present_posture.theta);
        status->leftEncoderPos = MotorParams[0].acccumulated_distance;
        status->rightEncoderPos = MotorParams[1].acccumulated_distance;
        status->lineVelocity = present_vw.sV;
        status->angularVelocity = DEGREE_TO_RADIAN(present_vw.sW);
        Navipack_UnlockReg(REG_ID_STATUS);
    }

    if(FREQ(stop_cnt, 500))
    {
        stop_cnt = 0;
        is_protect = DropAndCollisionSensorHandler(&target_vw, 500); // 碰撞及跌落传感器触发刹车策略
    }
    
    if(!is_protect)
    {
        if(VW_Update)
        {
            VW_Update = 0;
            target_vw = TargetSpeed;
        }
    }
    
    if(MotionCheckErr())
    {
        target_vw.sV = 0;
        target_vw.sW = 0;
    }
    
    SpeedLoop_SetTargetSpeed(&target_vw);
}

/**
* @brief  运动控制 Task
* @param  p_arg: 参数
* @retval None
*/
void MotionCtrlTask(void)
{
    static u8 motor_enable_flag = 1, drop_init_flag = 1;
    static u16 drop_init_cnt = 0;
    
    if(!RunFlag.motion) return;
    RunFlag.motion = 0;
    
    if(motor_enable_flag)
    {
        motor_enable_flag = 0;
        MotorPIDInit();
        ChassisMotorDriverEnable( true );
    }
    
    if(drop_init_flag)
    {
        if(drop_init_cnt < 500)
        {            
            InfraredDrop_InitData(true);
            drop_init_cnt++;
            return;
        }
        else
        {
            InfraredDrop_InitData(false);
            drop_init_flag = 0;
        }
    }

    ChassisMovingController();
}
