navipack/navi-panel/Software/HAL/Src/adc.c

/**
  ******************************************************************************
  * File Name          : ADC.c
  * Description        : This file provides code for the configuration
  *                      of the ADC instances.
  ******************************************************************************
  *
  * Copyright (c) 2017 STMicroelectronics International N.V. 
  * All rights reserved.
  *
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
  ******************************************************************************
  */

/* Includes ------------------------------------------------------------------*/
#include "adc.h"

#include "gpio.h"
#include "dma.h"

ADC_HandleTypeDef hadc1;
ADC_HandleTypeDef hadc2;
DMA_HandleTypeDef hdma_adc1;

/* ADC1 init function */
void MX_ADC1_Init(void)
{
  ADC_ChannelConfTypeDef sConfig;
  ADC_InjectionConfTypeDef sConfigInjected;

    /**Common config 
    */
  hadc1.Instance = ADC1;
  hadc1.Init.ScanConvMode = ADC_SCAN_ENABLE;
  hadc1.Init.ContinuousConvMode = ENABLE;
  hadc1.Init.DiscontinuousConvMode = DISABLE;
  hadc1.Init.ExternalTrigConv = ADC_SOFTWARE_START;
  hadc1.Init.DataAlign = ADC_DATAALIGN_RIGHT;
  hadc1.Init.NbrOfConversion = 8;
  if (HAL_ADC_Init(&hadc1) != HAL_OK)
  {
    Error_Handler();
  }

    /**Configure Regular Channel 
    */
  sConfig.Channel = ADC_CHANNEL_10;
  sConfig.Rank = 1;
  sConfig.SamplingTime = ADC_SAMPLETIME_41CYCLES_5;
  if (HAL_ADC_ConfigChannel(&hadc1, &sConfig) != HAL_OK)
  {
    Error_Handler();
  }

    /**Configure Regular Channel 
    */
  sConfig.Channel = ADC_CHANNEL_4;
  sConfig.Rank = 2;
  if (HAL_ADC_ConfigChannel(&hadc1, &sConfig) != HAL_OK)
  {
    Error_Handler();
  }

    /**Configure Regular Channel 
    */
  sConfig.Channel = ADC_CHANNEL_9;
  sConfig.Rank = 3;
  if (HAL_ADC_ConfigChannel(&hadc1, &sConfig) != HAL_OK)
  {
    Error_Handler();
  }

    /**Configure Regular Channel 
    */
  sConfig.Channel = ADC_CHANNEL_8;
  sConfig.Rank = 4;
  if (HAL_ADC_ConfigChannel(&hadc1, &sConfig) != HAL_OK)
  {
    Error_Handler();
  }

    /**Configure Regular Channel 
    */
  sConfig.Channel = ADC_CHANNEL_VREFINT;
  sConfig.Rank = 5;
  if (HAL_ADC_ConfigChannel(&hadc1, &sConfig) != HAL_OK)
  {
    Error_Handler();
  }

    /**Configure Regular Channel 
    */
  sConfig.Channel = ADC_CHANNEL_TEMPSENSOR;
  sConfig.Rank = 6;
  if (HAL_ADC_ConfigChannel(&hadc1, &sConfig) != HAL_OK)
  {
    Error_Handler();
  }

    /**Configure Regular Channel 
    */
  sConfig.Channel = ADC_CHANNEL_0;
  sConfig.Rank = 7;
  if (HAL_ADC_ConfigChannel(&hadc1, &sConfig) != HAL_OK)
  {
    Error_Handler();
  }

    /**Configure Regular Channel 
    */
  sConfig.Channel = ADC_CHANNEL_1;
  sConfig.Rank = 8;
  if (HAL_ADC_ConfigChannel(&hadc1, &sConfig) != HAL_OK)
  {
    Error_Handler();
  }

    /**Configure Injected Channel 
    */
  sConfigInjected.InjectedChannel = ADC_CHANNEL_2;
  sConfigInjected.InjectedRank = 1;
  sConfigInjected.InjectedNbrOfConversion = 1;
  sConfigInjected.InjectedSamplingTime = ADC_SAMPLETIME_7CYCLES_5;
  sConfigInjected.ExternalTrigInjecConv = ADC_EXTERNALTRIGINJECCONV_T1_TRGO;
  sConfigInjected.AutoInjectedConv = DISABLE;
  sConfigInjected.InjectedDiscontinuousConvMode = DISABLE;
  sConfigInjected.InjectedOffset = 0;
  if (HAL_ADCEx_InjectedConfigChannel(&hadc1, &sConfigInjected) != HAL_OK)
  {
    Error_Handler();
  }

}
/* ADC2 init function */
void MX_ADC2_Init(void)
{
  ADC_ChannelConfTypeDef sConfig;
  ADC_InjectionConfTypeDef sConfigInjected;

    /**Common config 
    */
  hadc2.Instance = ADC2;
  hadc2.Init.ScanConvMode = ADC_SCAN_DISABLE;
  hadc2.Init.ContinuousConvMode = ENABLE;
  hadc2.Init.DiscontinuousConvMode = DISABLE;
  hadc2.Init.ExternalTrigConv = ADC_SOFTWARE_START;
  hadc2.Init.DataAlign = ADC_DATAALIGN_RIGHT;
  hadc2.Init.NbrOfConversion = 1;
  if (HAL_ADC_Init(&hadc2) != HAL_OK)
  {
    Error_Handler();
  }

    /**Configure Regular Channel 
    */
  sConfig.Channel = ADC_CHANNEL_11;
  sConfig.Rank = 1;
  sConfig.SamplingTime = ADC_SAMPLETIME_41CYCLES_5;
  if (HAL_ADC_ConfigChannel(&hadc2, &sConfig) != HAL_OK)
  {
    Error_Handler();
  }

    /**Configure Injected Channel 
    */
  sConfigInjected.InjectedChannel = ADC_CHANNEL_12;
  sConfigInjected.InjectedRank = 1;
  sConfigInjected.InjectedNbrOfConversion = 1;
  sConfigInjected.InjectedSamplingTime = ADC_SAMPLETIME_7CYCLES_5;
  sConfigInjected.ExternalTrigInjecConv = ADC_EXTERNALTRIGINJECCONV_T1_TRGO;
  sConfigInjected.AutoInjectedConv = DISABLE;
  sConfigInjected.InjectedDiscontinuousConvMode = DISABLE;
  sConfigInjected.InjectedOffset = 0;
  if (HAL_ADCEx_InjectedConfigChannel(&hadc2, &sConfigInjected) != HAL_OK)
  {
    Error_Handler();
  }

}

void HAL_ADC_MspInit(ADC_HandleTypeDef* adcHandle)
{

  GPIO_InitTypeDef GPIO_InitStruct;
  if(adcHandle->Instance==ADC1)
  {
    /* Peripheral clock enable */
    __HAL_RCC_ADC1_CLK_ENABLE();
  
    /**ADC1 GPIO Configuration    
    PC0     ------> ADC1_IN10
    PA0-WKUP     ------> ADC1_IN0
    PA1     ------> ADC1_IN1
    PA2     ------> ADC1_IN2
    PA4     ------> ADC1_IN4
    PC4     ------> ADC1_IN14
    PB0     ------> ADC1_IN8
    PB1     ------> ADC1_IN9 
    */
    GPIO_InitStruct.Pin = DROP_IN4_Pin|DROP_IN_T_Pin;
    GPIO_InitStruct.Mode = GPIO_MODE_ANALOG;
    HAL_GPIO_Init(GPIOC, &GPIO_InitStruct);

    GPIO_InitStruct.Pin = GPIO_PIN_0|GPIO_PIN_1|I1_SEN_Pin|DROP_IN3_Pin;
    GPIO_InitStruct.Mode = GPIO_MODE_ANALOG;
    HAL_GPIO_Init(GPIOA, &GPIO_InitStruct);

    GPIO_InitStruct.Pin = DROP_IN1_Pin|DROP_IN2_Pin;
    GPIO_InitStruct.Mode = GPIO_MODE_ANALOG;
    HAL_GPIO_Init(GPIOB, &GPIO_InitStruct);

    /* Peripheral DMA init*/
  
    hdma_adc1.Instance = DMA1_Channel1;
    hdma_adc1.Init.Direction = DMA_PERIPH_TO_MEMORY;
    hdma_adc1.Init.PeriphInc = DMA_PINC_DISABLE;
    hdma_adc1.Init.MemInc = DMA_MINC_ENABLE;
    hdma_adc1.Init.PeriphDataAlignment = DMA_PDATAALIGN_HALFWORD;
    hdma_adc1.Init.MemDataAlignment = DMA_MDATAALIGN_HALFWORD;
    hdma_adc1.Init.Mode = DMA_CIRCULAR;
    hdma_adc1.Init.Priority = DMA_PRIORITY_MEDIUM;
    if (HAL_DMA_Init(&hdma_adc1) != HAL_OK)
    {
      Error_Handler();
    }

    __HAL_LINKDMA(adcHandle,DMA_Handle,hdma_adc1);

    /* Peripheral interrupt init */
    HAL_NVIC_SetPriority(ADC1_2_IRQn, 1, 0);
    HAL_NVIC_EnableIRQ(ADC1_2_IRQn);
  }
  else if(adcHandle->Instance==ADC2)
  {
    /* Peripheral clock enable */
    __HAL_RCC_ADC2_CLK_ENABLE();
  
    /**ADC2 GPIO Configuration    
    PC1     ------> ADC2_IN11
    PC2     ------> ADC2_IN12 
    */
    GPIO_InitStruct.Pin = AD_12V_Pin|I4_SEN_Pin;
    GPIO_InitStruct.Mode = GPIO_MODE_ANALOG;
    HAL_GPIO_Init(GPIOC, &GPIO_InitStruct);

    /* Peripheral interrupt init */
    HAL_NVIC_SetPriority(ADC1_2_IRQn, 1, 0);
    HAL_NVIC_EnableIRQ(ADC1_2_IRQn);
  }
}

void HAL_ADC_MspDeInit(ADC_HandleTypeDef* adcHandle)
{

  if(adcHandle->Instance==ADC1)
  {
    /* Peripheral clock disable */
    __HAL_RCC_ADC1_CLK_DISABLE();
  
    /**ADC1 GPIO Configuration    
    PC0     ------> ADC1_IN10
    PA0-WKUP     ------> ADC1_IN0
    PA1     ------> ADC1_IN1
    PA2     ------> ADC1_IN2
    PA4     ------> ADC1_IN4
    PC4     ------> ADC1_IN14
    PB0     ------> ADC1_IN8
    PB1     ------> ADC1_IN9 
    */
    HAL_GPIO_DeInit(GPIOC, DROP_IN4_Pin|DROP_IN_T_Pin);

    HAL_GPIO_DeInit(GPIOA, GPIO_PIN_0|GPIO_PIN_1|I1_SEN_Pin|DROP_IN3_Pin);

    HAL_GPIO_DeInit(GPIOB, DROP_IN1_Pin|DROP_IN2_Pin);

    /* Peripheral DMA DeInit*/
    HAL_DMA_DeInit(adcHandle->DMA_Handle);

    /* Peripheral interrupt Deinit*/
  /* USER CODE BEGIN ADC1:ADC1_2_IRQn disable */
    /**
    * Uncomment the line below to disable the "ADC1_2_IRQn" interrupt
    * Be aware, disabling shared interrupt may affect other IPs
    */
    /* HAL_NVIC_DisableIRQ(ADC1_2_IRQn); */
  /* USER CODE END ADC1:ADC1_2_IRQn disable */

  }
  else if(adcHandle->Instance==ADC2)
  {
    /* Peripheral clock disable */
    __HAL_RCC_ADC2_CLK_DISABLE();
  
    /**ADC2 GPIO Configuration    
    PC1     ------> ADC2_IN11
    PC2     ------> ADC2_IN12 
    */
    HAL_GPIO_DeInit(GPIOC, AD_12V_Pin|I4_SEN_Pin);

    /* Peripheral interrupt Deinit*/
  /* USER CODE BEGIN ADC2:ADC1_2_IRQn disable */
    /**
    * Uncomment the line below to disable the "ADC1_2_IRQn" interrupt
    * Be aware, disabling shared interrupt may affect other IPs
    */
    /* HAL_NVIC_DisableIRQ(ADC1_2_IRQn); */
  /* USER CODE END ADC2:ADC1_2_IRQn disable */

  }
} 

/**
  * @}
  */

/**
  * @}
  */

/************************ (C) COPYRIGHT STMicroelectronics *****END OF FILE****/
