navipack/navi-panel/Software/Source/Arithmetic/math_lib.c

/**
******************************************************************************
* @file    math_lib.c
* @author  Inmotion NaviPanel team
* @date    2016/09/14
* @brief   数学函数库
* @attention Copyright (C) 2016 Inmotion Corporation
******************************************************************************
*/

#include "math_lib.h"

/* Const Tables ---------------------------------------------*/

// Sin 真值表，步长为0.09，总长度为正负90
const s32 SinTable[2001] = {
4096	,	4096	,	4096	,	4096	,	4096	,	4096	,	4095	,	4095	,	4095	,	4095	,
4095	,	4095	,	4095	,	4095	,	4095	,	4094	,	4094	,	4094	,	4094	,	4094	,
4093	,	4093	,	4093	,	4093	,	4093	,	4092	,	4092	,	4092	,	4092	,	4091	,
4091	,	4091	,	4090	,	4090	,	4090	,	4089	,	4089	,	4089	,	4088	,	4088	,
4087	,	4087	,	4087	,	4086	,	4086	,	4085	,	4085	,	4084	,	4084	,	4083	,
4083	,	4082	,	4082	,	4081	,	4081	,	4080	,	4080	,	4079	,	4079	,	4078	,
4077	,	4077	,	4076	,	4075	,	4075	,	4074	,	4074	,	4073	,	4072	,	4071	,
4071	,	4070	,	4069	,	4069	,	4068	,	4067	,	4066	,	4066	,	4065	,	4064	,
4063	,	4062	,	4062	,	4061	,	4060	,	4059	,	4058	,	4057	,	4056	,	4056	,
4055	,	4054	,	4053	,	4052	,	4051	,	4050	,	4049	,	4048	,	4047	,	4046	,
4045	,	4044	,	4043	,	4042	,	4041	,	4040	,	4039	,	4038	,	4037	,	4036	,
4035	,	4033	,	4032	,	4031	,	4030	,	4029	,	4028	,	4027	,	4025	,	4024	,
4023	,	4022	,	4021	,	4019	,	4018	,	4017	,	4016	,	4014	,	4013	,	4012	,
4010	,	4009	,	4008	,	4006	,	4005	,	4004	,	4002	,	4001	,	4000	,	3998	,
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
25827	,	25943	,	26059	,	26175	,	26291	,	26407	,	26523	,	26638	,	26754	,	26870	,
26986	,	27102	,	27217	,	27333	,	27449	,	27565	,	27680	,	27796	,	27912	,	28028	,
28143	,	28259	,	28374	,	28490	,	28606	,	28721	,	28837	,	28952	,	29068	,	29184	,
29299	,	29415	,	29530	,	29646	,	29761	,	29877	,	29992	,	30107	,	30223	,	30338	,
30454	,	30569	,	30684	,	30800	,	30915	,	31030	,	31146	,	31261	,	31376	,	31491	,
31607	,	31722	,	31837	,	31952	,	32067	,	32183	,	32298	,	32413	,	32528	,	32643	,
32758	,	32873	,	32988	,	33103	,	33218	,	33333	,	33448	,	33563	,	33678	,	33793	,
33908	,	34023	,	34138	,	34253	,	34368	,	34482	,	34597	,	34712	,	34827	,	34942	,
35056	,	35171	,	35286	,	35400	,	35515	,	35630	,	35744	,	35859	,	35974	,	36088	,
36203	,	36317	,	36432	,	36546	,	36661	,	36775	,	36890	,	37004	,	37119	,	37233	,
37348	,	37462	,	37576	,	37691	,	37805	,	37919	,	38034	,	38148	,	38262	,	38377	,
38491	,	38605	,	38719	,	38833	,	38947	,	39062	,	39176	,	39290	,	39404	,	39518	,
39632	,	39746	,	39860	,	39974	,	40088	,	40202	,	40316	,	40430	,	40544	,	40657	,
40771	,	40885	,	40999	,	41113	,	41226	,	41340	,	41454	,	41568	,	41681	,	41795	,
41909	,	42022	,	42136	,	42249	,	42363	,	42477	,	42590	,	42704	,	42817	,	42931	,
43044	,	43157	,	43271	,	43384	,	43498	,	43611	,	43724	,	43838	,	43951	,	44064	,
44177	,	44291	,	44404	,	44517	,	44630	,	44743	,	44856	,	44969	,	45083	,	45196	,
45309	,	45422	,	45535	,	45648	,	45761	,	45873	,	45986	,	46099	,	46212	,	46325	,
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
};


/**
* @brief  返回x的绝对值
* @param  x:输入数据
* @retval 输出绝对值
*/
s32 GetAbs(s32 x)
{
	s32 tmp;
	tmp = x >= 0 ? x : (-x);
	return tmp;
}

/**
* @brief  返回x的平方根
* @param  x:输入数据
* @retval 平方根
* @note:  输入类型和输出类型为int类型
*/
s32 GetSqurt32(s32 x)
{
	u32 i;
	u32 input_data = (u32)(x);
	u32 rem = 0;     
	u32 root = 0;    
	u32 divisor = 0;    

	for(i = 0; i < 16; i++)
	{      
		root <<= 1;        
		rem = ((rem << 2) + (input_data >> 30));      
		input_data <<= 2;        
		divisor = (root<<1) + 1;      
		if(divisor <= rem)
		{         
			rem -= divisor;        
			root++;       
		}    
	}  
	
	return ((s32)(root));
}


/**
* @brief  返回Sin(x)值
* @param   x 输入角度，范围正负 DEGREE(90)
* @retval 输出正弦值，范围正负4096
*/
s32 GetSin(s32 x)
{
	s32 SinValue;
	s32 index = (DEGREE(90) * 2048 - x * 2048) / (DEGREE(90)*2048/1000); //754975

	if(index > 2000)
		index = 2000;
	else if(index < 0)
		index = 0;
	
	if(GetAbs(x) < 40960)
		SinValue = x * 6434 / 180 / 2048;
	else
		SinValue = SinTable[index];
		
	return SinValue;
}

/**
* @brief  返回Cos(x)值
* @param  x： 输入角度，范围正负 DEGREE(90)
* @retval 输出余弦值，范围正负4096
*/
s32 GetCos(s32 x)
{
	s32 tmp;
	tmp = GetSqurt32(SQUARE(4096) - SQUARE(GetSin(x)));
	return tmp;
}

/**
* @brief  返回Asin(x)值
* @param  x： 输入数据，范围为正负4096
* @retval 输出反正弦值，范围为正负 DEGREE(90)
*/
s32 GetAsin(s32 x)
{
	s32 AsinValue;
	s32 index = (4096 * 4096  - x * 4096) / (4096*4096/1000);
	
	if(index > 2000)
		index = 2000;
	else if(index < 0)
		index = 0;
	
	if(GetAbs(x) < 1060)
		AsinValue = x * 4096 * 180 / 12868; 
	else if(GetAbs(x) < 2633)
	{
		s32 tmp1,tmp2;
		tmp1 = AsinTable[index];
		tmp2 = x * 4096 * 180 / 12868;
		AsinValue = (tmp1 + tmp2) / 2;
	}
	else 
		AsinValue = AsinTable[index];

	return AsinValue;
}

/**
* @brief  返回Atan(x)值
* @param  x： 输入数据
* @param  y： 输入数据，
* @param  flag：选择输出范围
* @retval 输出反正切值，范围为正负737280，或者0 — 1474560
* @note   x,y不能同时为0
*/
s32 GetAtan(s32 x, s32 y, s32 flag)
{
	s32 AtanValue;
	s32 tmp, index, quad_flag;
	s32 abs_x = GetAbs(x);
	s32 abs_y = GetAbs(y);

	if(abs_x >= abs_y)
	{
		quad_flag = 1;
		tmp = abs_y * 4096 / abs_x;
	}
	else 
	{
		quad_flag = 0;
		tmp = abs_x* 4096 / abs_y;
	}
	
	index = tmp * 4096 / 8389;
	
	if(index > 1999)
		index = 1999;
	else if(index < 0)
		index = 0;
	
	if(x == 0)
	{
		if(y == 0)
			AtanValue = 0;		
		else if(y > 0)
			AtanValue = 90*4096;
		else 
			AtanValue = -90*4096;
	}
	else if(y == 0)
	{
		if(x > 0)
			AtanValue = 0;
		else 
			AtanValue = 180*4096;
	}
	else 
	{
		if(quad_flag)
			AtanValue = AtanTable[index];
		else
			AtanValue = DEGREE(90) - AtanTable[index];
		
		if(x > 0 && y > 0);   //第一象限
		else if(x < 0 && y > 0) //第二象限
			AtanValue = 737280 - AtanValue;
		else if(x <0 && y < 0) //第三象限
			AtanValue = AtanValue - 737280;
		else                  //第四象限
			AtanValue = -AtanValue;
	}
	
	//0 — 360度 
	if(flag && (AtanValue < 0))
		AtanValue += 1474560;
	
	return AtanValue;
}

#define LINE_CALC 10

/**
* @brief  由两点表示一条直线
* @param  firstpoint： 第一个点
* @param  secondpoint： 第二个点
* @retval 直线参数
* @note   LineParameter.a代表斜率，LineParameter.b代表长度 LineParameter.flag判断是否为垂直x轴
          当直线为垂直x轴时，LineParameter.a=x轴坐标相交点，LineParameter.flag为ture
*/
LineParameter CalculateLine( const PointCoordinate* firstpoint, const PointCoordinate* secondpoint )
{
    LineParameter param;
    
    if( secondpoint->x != firstpoint->x )
    {
        param.flag = false;
        param.a = (( secondpoint->y - firstpoint->y ) << LINE_CALC)/( secondpoint->x - firstpoint->x );
        param.b = (s64)(secondpoint->y << LINE_CALC) -  (s64)(param.a * secondpoint->x); 
    }
    else
    {
        param.flag = true;
        param.a = secondpoint->x;
        param.b = 0;
    }
    
    return  param;
}

/**
* @brief  通过已知直线和垂点，求垂直线
* @param  line： 已知直线
* @param  foot： 垂点
* @retval 直线参数
* @note   LineParameter.a代表斜率，LineParameter.b代表长度 LineParameter.flag判断是否为垂直x轴
          当直线为垂直x轴时，LineParameter.a=x轴坐标相交点，LineParameter.flag为ture
*/
LineParameter CalculateVerticalLine( const LineParameter* line, const PointCoordinate* foot )
{
    LineParameter vertical;
    
    if( line->flag )
    {
        vertical.a = 0;
        vertical.b = (s64)foot->y << LINE_CALC;
        vertical.flag = false;
    }
    else
    {
        if( line->a == 0 )
        {
            vertical.a = (s64)foot->x;
            vertical.b = 0;
            vertical.flag = true;
        }
        else
        {
            vertical.a = -((s64)(1 << LINE_CALC) * (s64)(1 << LINE_CALC))/line->a;
            vertical.b = ((s64)foot->y << LINE_CALC) - vertical.a * (s64)foot->x;   
            vertical.flag = false;
        }
    }
    
    return  vertical;
}
