navipack/navi-panel/Software/Source/Driver/gpio_user.c

/**
******************************************************************************
* @file    gpio_user.c
* @author  Inmotion NaviPanel team
* @date    2016/09/14
* @brief   GPIO 相关驱动
* @attention Copyright (C) 2016 Inmotion Corporation
******************************************************************************
*/

#include "gpio_user.h"

/**
* @brief  Led流水灯
* @param  None
* @retval None
* @note  每执行一次翻转一次led引口的电平
*/
void LedToggle(void)
{
    HAL_GPIO_TogglePin(LED_GPIO_Port, LED_Pin);
}

/**
* @brief  激光雷达供电控制
* @param  on：true 上电，false 断电
* @retval None
*/
void LidarPower(bool on)
{
    if( on )
    {
        HAL_GPIO_WritePin(RADAR_PWR_BUTTON_GPIO_Port, RADAR_PWR_BUTTON_Pin, GPIO_PIN_SET);
    }
    else
    {
        HAL_GPIO_WritePin(RADAR_PWR_BUTTON_GPIO_Port, RADAR_PWR_BUTTON_Pin, GPIO_PIN_RESET);
    }
}

/**
* @brief  超声波模块供电控制
* @param  on：true 上电，false 断电
* @retval None
*/
void UltrasonicPower(bool on)
{
    if( on )
    {
        HAL_GPIO_WritePin(UR_PWR_BUTTON_GPIO_Port, UR_PWR_BUTTON_Pin, GPIO_PIN_SET);
    }
    else
    {
        HAL_GPIO_WritePin(UR_PWR_BUTTON_GPIO_Port, UR_PWR_BUTTON_Pin, GPIO_PIN_RESET);
    }
}

/**
* @brief  地侧模块供电控制
* @param  on：true 上电，false 断电
* @retval None
*/
void DropPower(bool on)
{
    if( on )
    {
        HAL_GPIO_WritePin(DROP_POWE_EN_GPIO_Port, DROP_POWE_EN_Pin, GPIO_PIN_SET);
    }
    else
    {
        HAL_GPIO_WritePin(DROP_POWE_EN_GPIO_Port, DROP_POWE_EN_Pin, GPIO_PIN_RESET);
    }
}

/**
* @brief  电机驱动芯片使能
* @param  on：true 上电，false 断电
* @retval None
*/
void ChassisMotorDriverEnable(bool on)
{
    if( on )
    {
        HAL_GPIO_WritePin(SHDNB_12_GPIO_Port, SHDNB_12_Pin, GPIO_PIN_SET);
    }
    else
    {
        HAL_GPIO_WritePin(SHDNB_12_GPIO_Port, SHDNB_12_Pin, GPIO_PIN_RESET);
    }
    
}

bool IsPickUp(void)
{
    return false;
}

bool GetCommMode(void)
{
    return HAL_GPIO_ReadPin(COMM_MODE_GPIO_Port, COMM_MODE_Pin) == GPIO_PIN_SET;
}
