navipack/navi-panel/Software/Source/App/global.c

/**
******************************************************************************
* @file    global.c
* @author  Inmotion NaviPanel team
* @date    2016/09/14
* @brief   一些全局变量
* @attention Copyright (C) 2016 Inmotion Corporation
******************************************************************************
*/

#include "global_defines.h"

GlobalParamsType GlobalParams = {
    .err_status = 0
};
