navipack/navi-panel/Software/Source/Arithmetic/AVG_filter.h

/**
******************************************************************************
* @file    AVG_Filter.h
* @author  Jalon
* @date    2016/06/29
* @brief   均值滤波器
******************************************************************************
*/

/* Define to prevent recursive inclusion -------------------------------------*/
#ifndef __AVG_FILTER_H__
#define __AVG_FILTER_H__

/* Includes ------------------------------------------------------------------*/
#include "stm32_lib.h"

/* Exported types ------------------------------------------------------------*/
typedef struct AvgFilterInt32DefStruct
{
	s32 *delay;     ///< 缓存区指针
	u16 tap;        ///< 缓存区尺寸
    u16 index;
    s64 sum;
}AvgFilterInt32Def;

/* Exported constants --------------------------------------------------------*/
/* Exported macro ------------------------------------------------------------*/

/* Exported functions --------------------------------------------------------*/
s32 AVG_Filter_s32(AvgFilterInt32Def *filter, s32 invar) ;
void AVG_Filter_Clear_s32(AvgFilterInt32Def *filter);

/* Exported variables ------------------------------------------------------- */

#endif
