navipack/navi-panel/Software/Source/Driver/stm32_lib.h

#ifndef __STM32_LIB_H__
#define __STM32_LIB_H__

#include "stm32f1xx_hal.h"
#include <stdbool.h>

typedef float f32;
typedef double  f64;

typedef int64_t s64;
typedef int32_t  s32;
typedef int16_t s16;
typedef int8_t  s8;

typedef const int32_t sc32;  /*!< Read Only */
typedef const int16_t sc16;  /*!< Read Only */
typedef const int8_t sc8;   /*!< Read Only */

typedef __IO int32_t  vs32;
typedef __IO int16_t  vs16;
typedef __IO int8_t   vs8;

typedef __I int32_t vsc32;  /*!< Read Only */
typedef __I int16_t vsc16;  /*!< Read Only */
typedef __I int8_t vsc8;   /*!< Read Only */

typedef uint64_t u64;
typedef uint32_t  u32;
typedef uint16_t u16;
typedef uint8_t  u8;

typedef const uint32_t uc32;  /*!< Read Only */
typedef const uint16_t uc16;  /*!< Read Only */
typedef const uint8_t uc8;   /*!< Read Only */

typedef __IO uint32_t  vu32;
typedef __IO uint16_t vu16;
typedef __IO uint8_t  vu8;

typedef __I uint32_t vuc32;  /*!< Read Only */
typedef __I uint16_t vuc16;  /*!< Read Only */
typedef __I uint8_t vuc8;   /*!< Read Only */

#define U8_MAX     ((u8)255)
#define S8_MAX     ((s8)127)
#define S8_MIN     ((s8)-128)
#define U16_MAX    ((u16)65535u)
#define S16_MAX    ((s16)32767)
#define S16_MIN    ((s16)-32768)
#define U32_MAX    ((u32)4294967295uL)
#define S32_MAX    ((s32)2147483647)
#define S32_MIN    ((s32)-2147483648)

#endif
