navipack/navi-panel/(commit log)

2016-09-14 添加驱动软件初始源文件
2016-09-14 添加通讯心跳恢复和包数统计
2016-09-18 测温芯片驱动使能，超声波数据反馈调整
2016-09-19 碰撞模块
2016-09-19 注释补充
2016-09-20 电压指令灯控制
2016-09-20 添加注释
2016-09-20 添加 USB COM 通讯驱动
2016-09-21 encoder 命名改进
2016-09-21 速度采样改进
2016-09-21 添加通讯方式切换接口
2016-09-21 代码整理
2016-09-21 USART 采用 DMA 接收数据
2016-09-23 更改通讯切换 PIN
2016-09-23 将速度环分离到定时中断里
2016-09-23 注释修改
2016-09-27 HAL修改
2016-10-09 添加文件并更新 Readme
2016-10-09 代码修改
2016-10-09 添加文档
2016-10-09 结构体成员命名修改
2016-10-10 通讯 sdk 更新
2016-10-10 硬件资料更新
2016-10-11 CubeMX 升级至 4.17.0
2016-10-14 超声波通道转换更改
2016-10-18 修改串口 DMA 收发的代码，使其可以复用于多个串口。
2016-10-20 Fix 通讯串口初始化异常的问题
2016-10-25 保护超时逻辑改进
2016-10-26 IMU 相关代码优化
2016-11-02 缩进格式整理
2016-11-07 宏名称调整
2016-11-23 碰撞及跌落处理代码整理
2016-11-25 通讯协议更新变量清理
2017-01-12 cubemx 更新
2017-01-20 编码器相关代码精简
2017-02-16 Fixed 串口收发接口复用异常的 bug
2017-02-23 通讯协议传输层精简
2017-02-23 传输层精简，利于单独移植
2017-02-23 停车后关闭速度环环
2017-02-23 新版电路适配及 cubemx 更新
2017-03-20 v1.0 适配，超声波通道调整，V_FACTOR，轮系数及速度环参数调整。(lin)
2017-04-05 修正关闭速度闭环的逻辑
2017-04-05 开启地测保护逻辑
2017-04-06 编码器速度计算移出中断
2017-04-06 修改角速度环参数
